Andy-Cheng1017/LEDCeliling/img/P4-indoor-full-color-LED-display-panel-256-256mm-64-64-dots-SMD2121-RGB.jpg

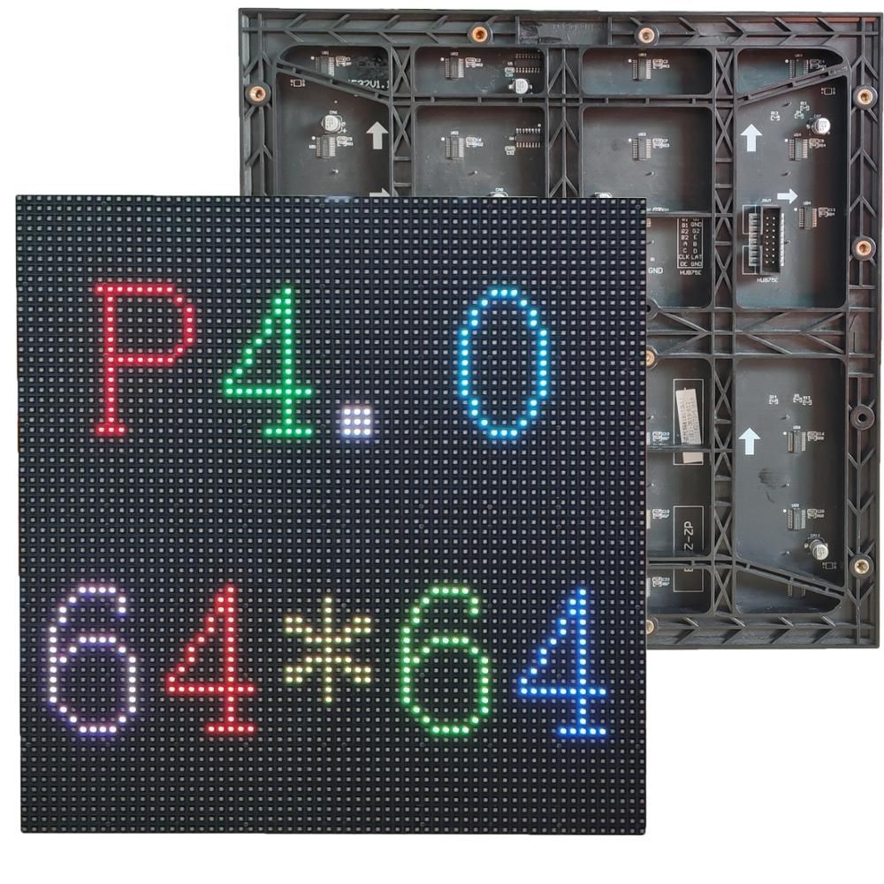
img/P4-indoor-full-color-LED-display-panel-256-256mm-64-64-dots-SMD2121-RGB.jpg
