Andy-Cheng1017/LEDCeliling/img/conbine v13.png

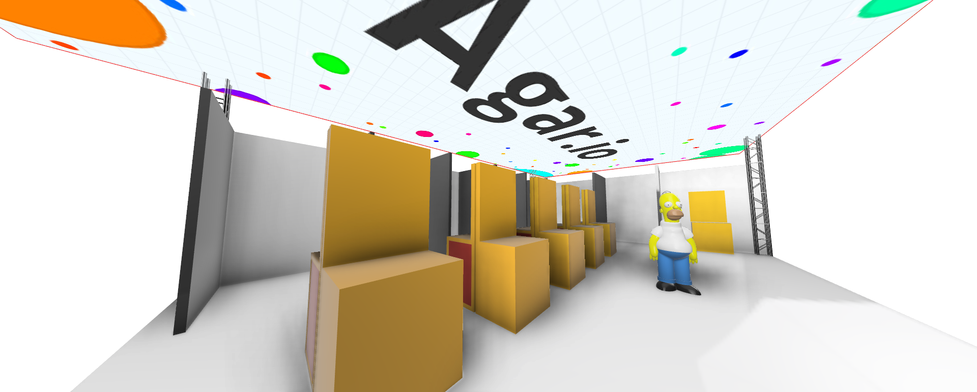
img/conbine v13.png
