Andy-Cheng1017/LEDCeliling/README.md

# LEDCeliling
 NTUT IXD Graduate Exhibition
