Andy-Cheng1017/LEDCeliling/1663770847968.jpg

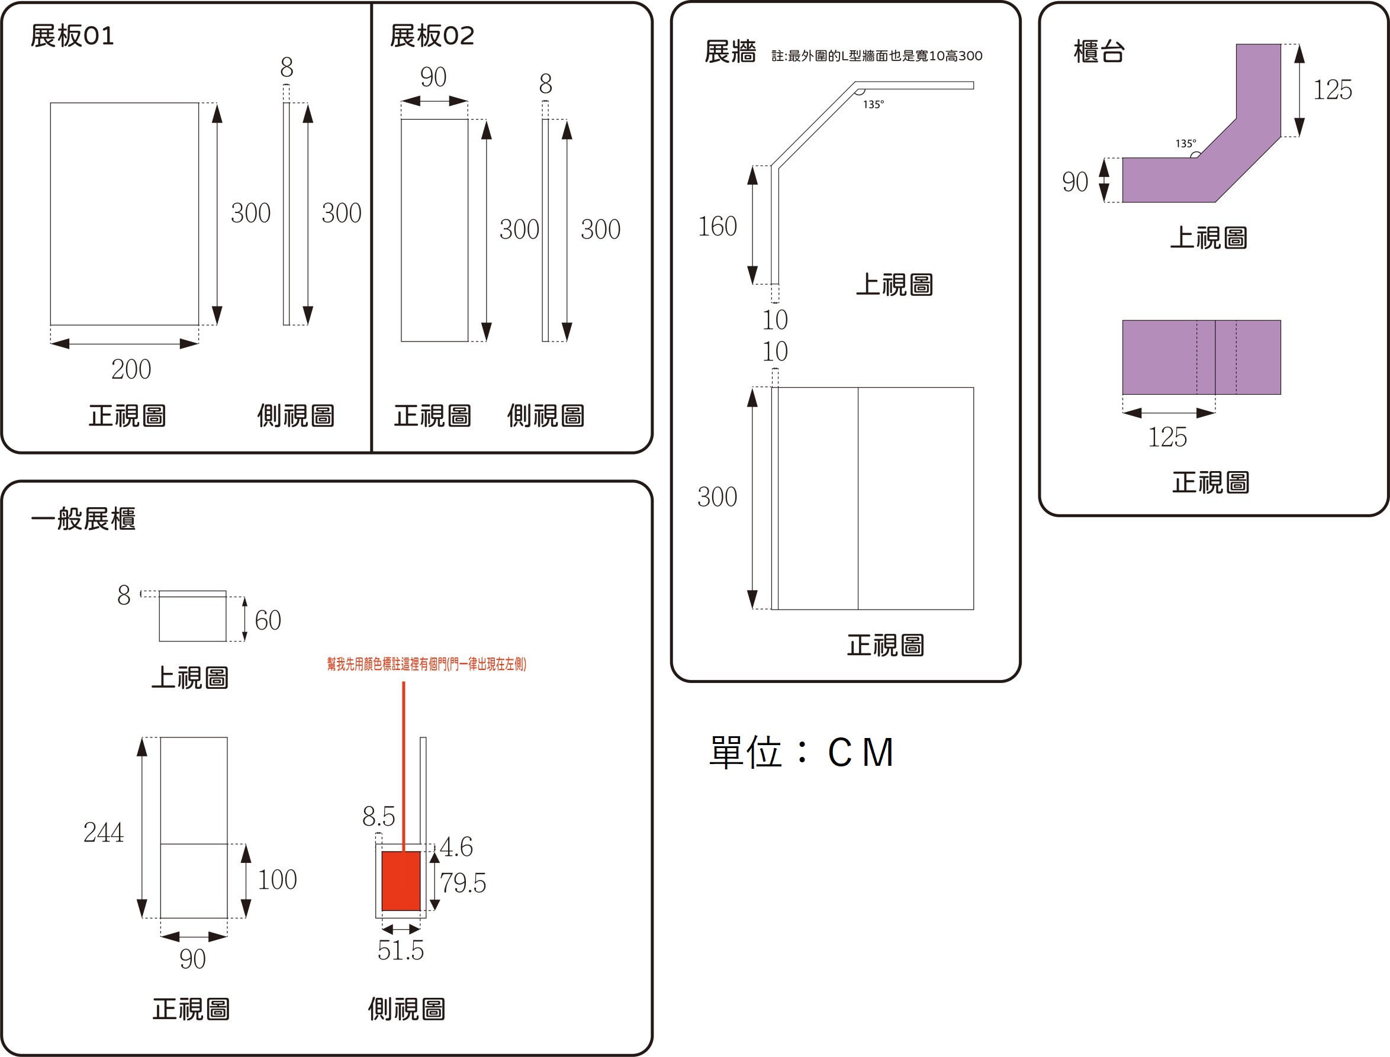
1663770847968.jpg
