Andy-Cheng1017/LEDCeliling/1663770881538.jpg

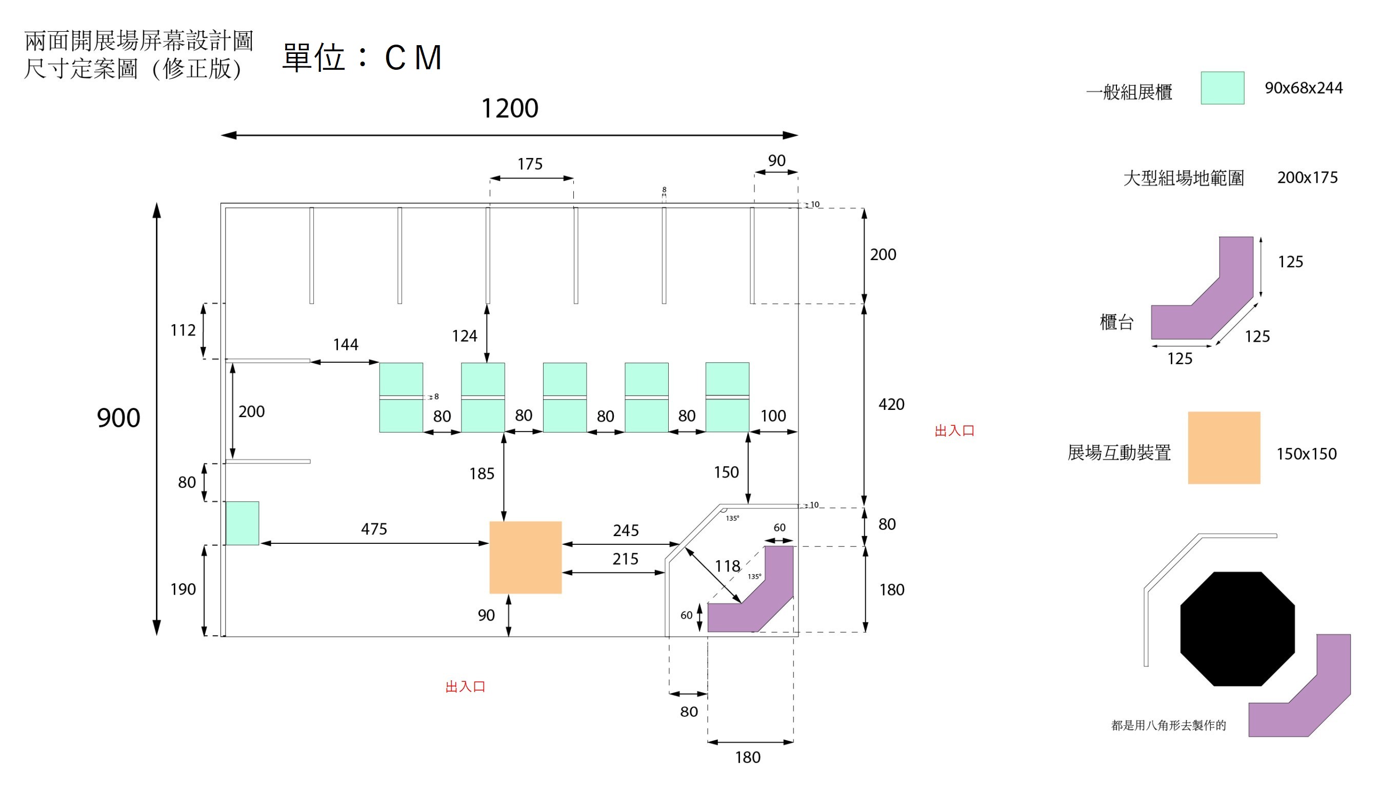
1663770881538.jpg
