Andy-Cheng1017/LEDCeliling/BoardCoverter/BoardCoverterPanelization.png

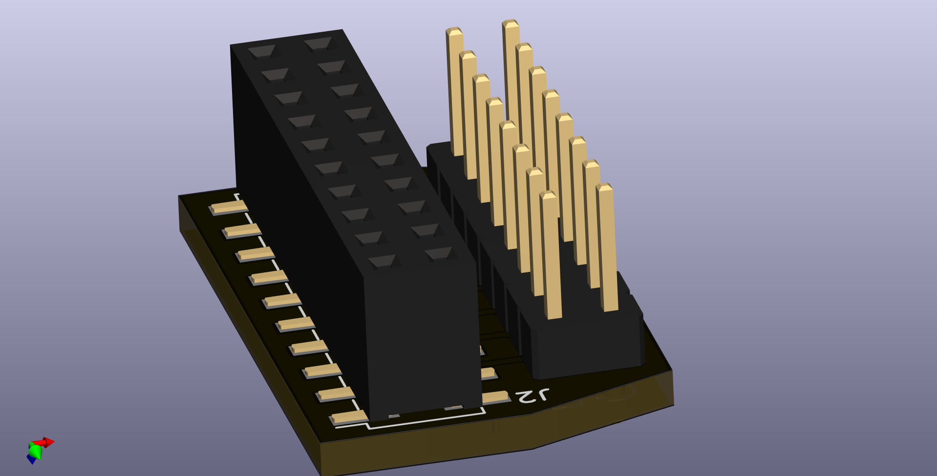
BoardCoverter/BoardCoverterPanelization.png
