Andy-Cheng1017/LEDCeliling/CameraPosition/2023-02-24 09.29.34.png

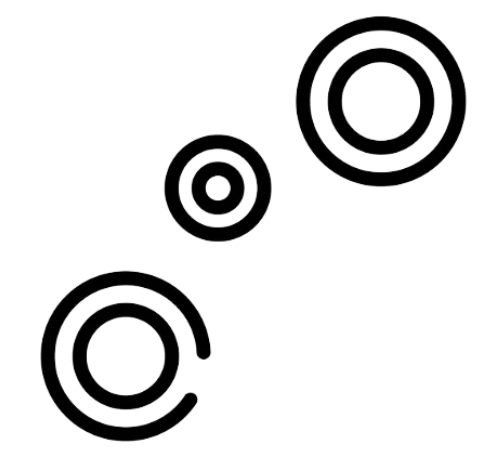
CameraPosition/2023-02-24 09.29.34.png
