Andy-Cheng1017/LEDCeliling/CameraPosition/CameraPosition2.png

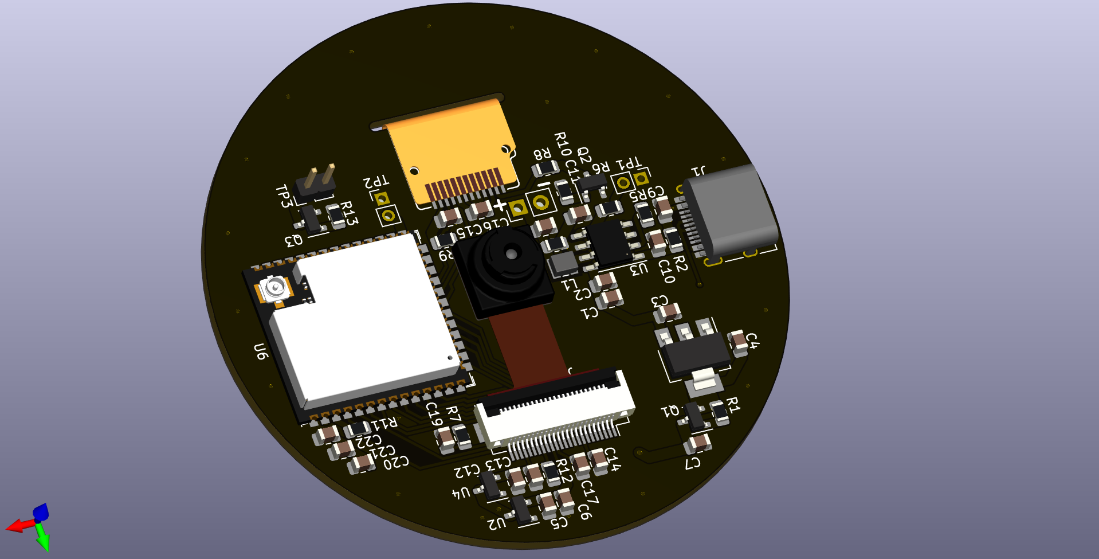
CameraPosition/CameraPosition2.png
