Andy-Cheng1017/LEDCeliling/CameraPosition/CameraPosition.png

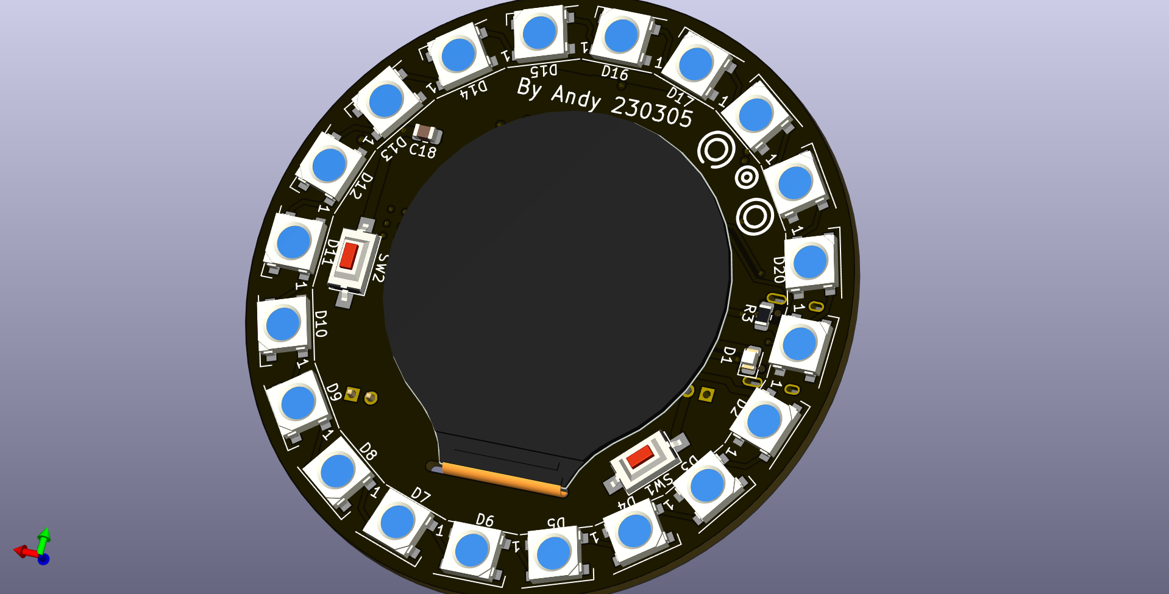
CameraPosition/CameraPosition.png
