Andy-Cheng1017/LEDCeliling/img/conbine 11.png

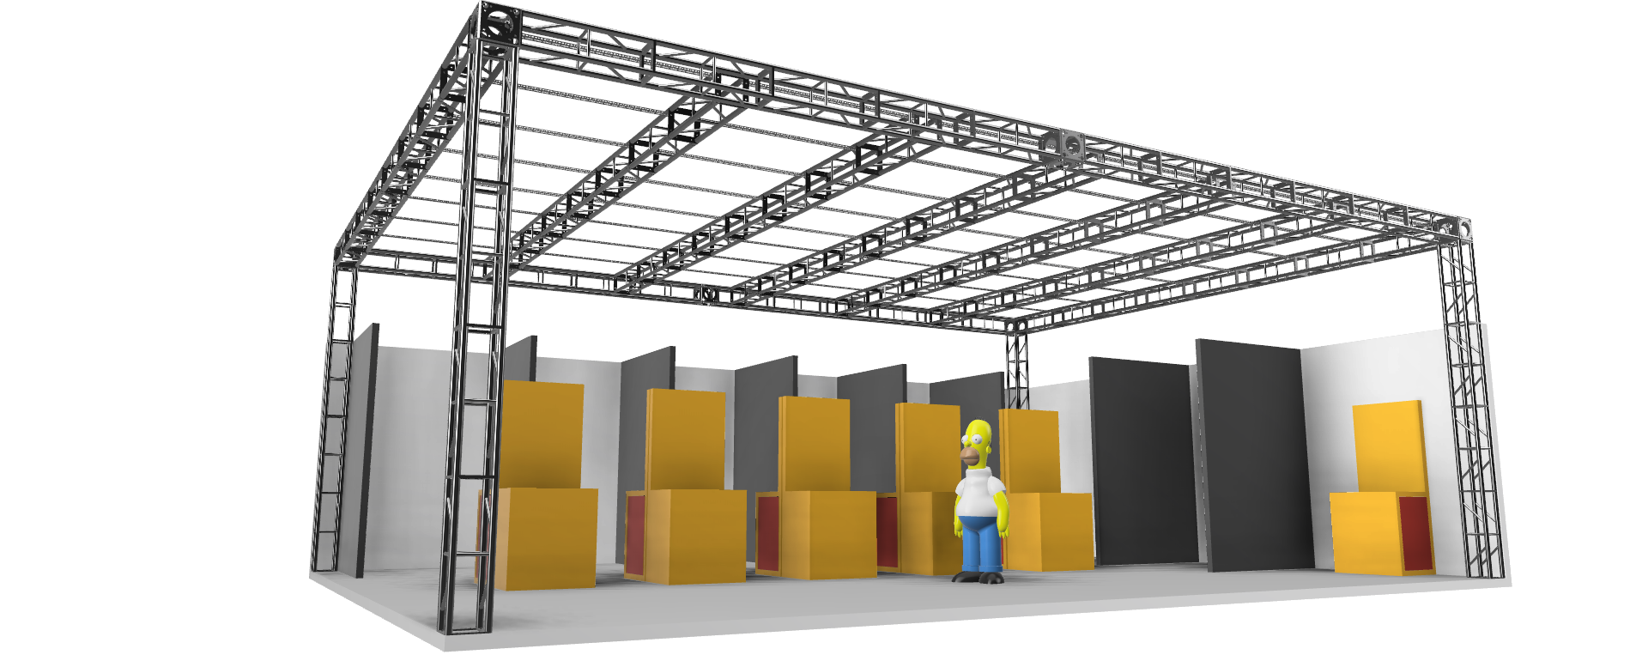
img/conbine 11.png
