Andy-Cheng1017/LEDCeliling/img/conbine v.png

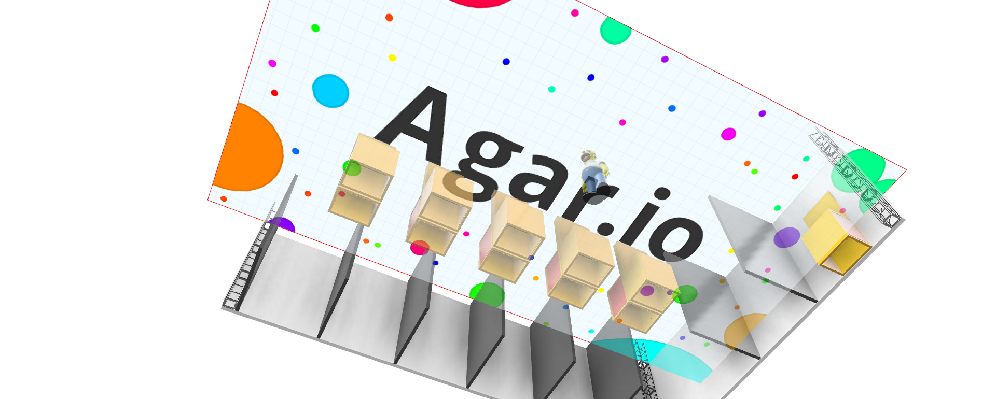
img/conbine v.png
