Andy-Cheng1017/LEDCeliling/img/Ibecon.drawio.png

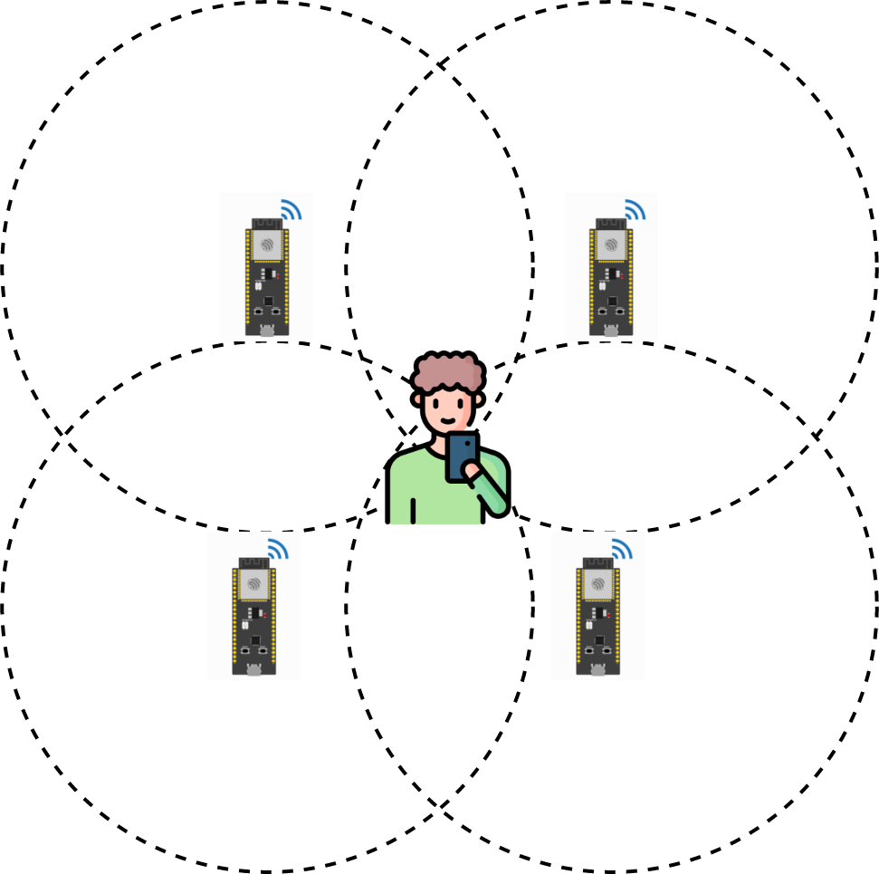
img/Ibecon.drawio.png
