Andy-Cheng1017/LEDCeliling/img/LED矩陣關係.drawio.png

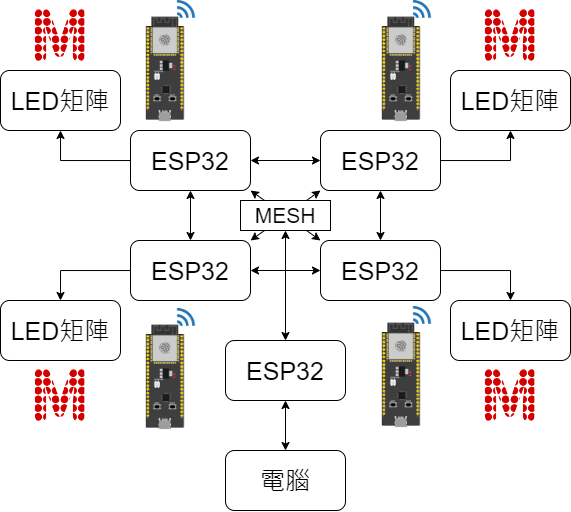
img/LED矩陣關係.drawio.png
