Andy-Cheng1017/LEDCeliling/img/Matrix.io (1).png

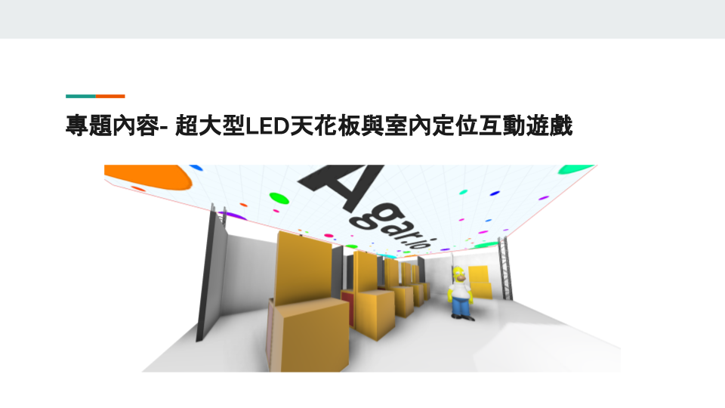
img/Matrix.io (1).png
