Andy-Cheng1017/LEDCeliling/img/Matrix.io (2).png

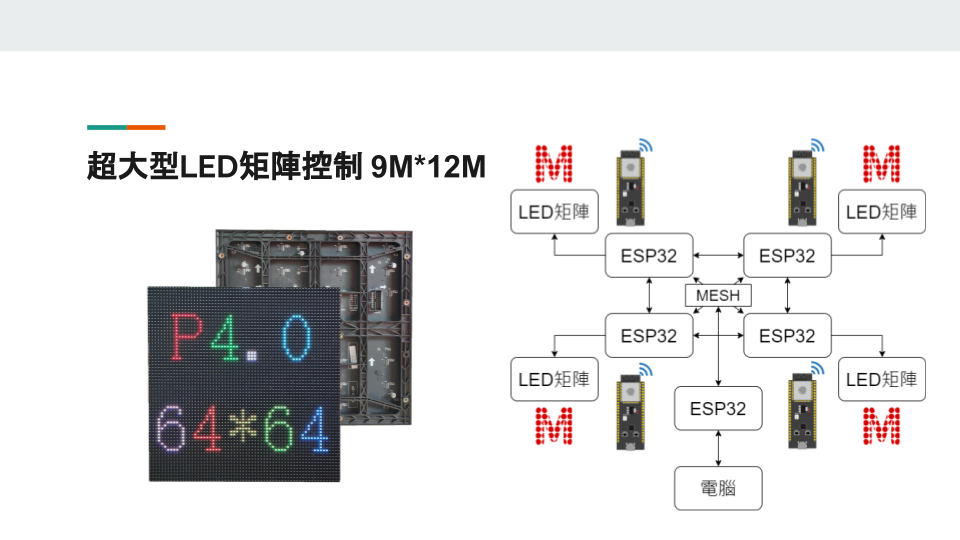
img/Matrix.io (2).png
