Andy-Cheng1017/LEDCeliling/img/Matrix.io (3).png

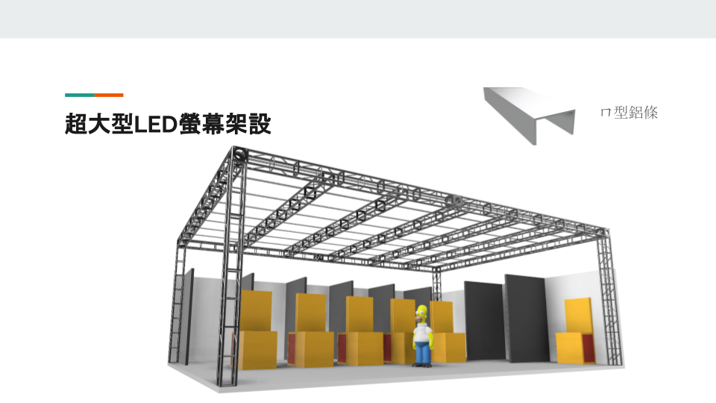
img/Matrix.io (3).png
