Andy-Cheng1017/LEDCeliling/img/Matrix.io (4).png

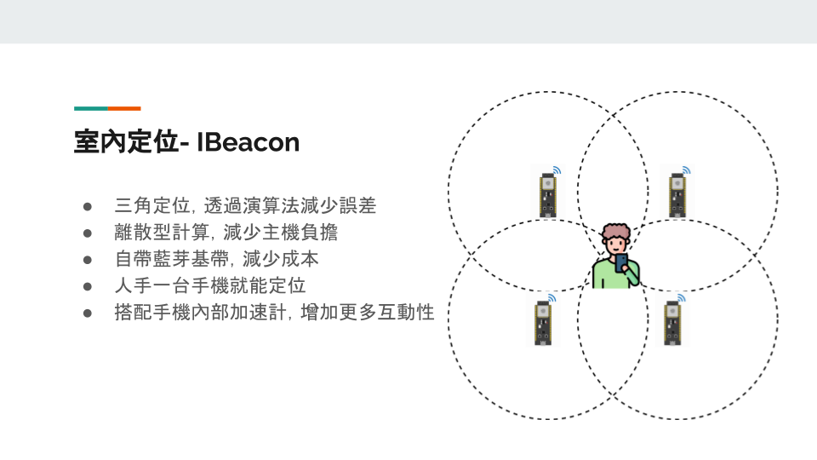
img/Matrix.io (4).png
