Andy-Cheng1017/LEDCeliling/img/Matrix.io (5).png

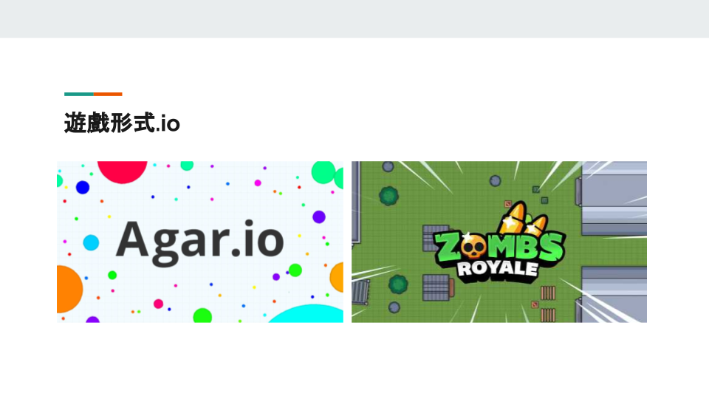
img/Matrix.io (5).png
