Andy-Cheng1017/LEDCeliling/img/Matrix.io (6).png

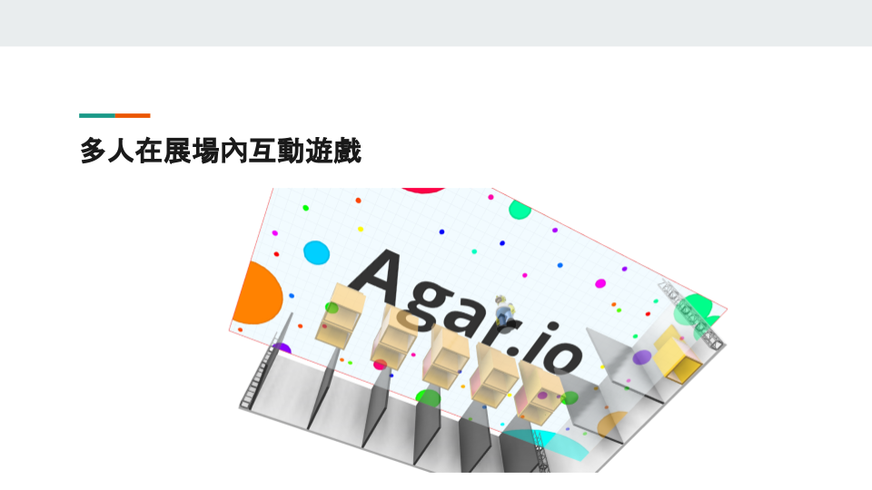
img/Matrix.io (6).png
