Andy-Cheng1017/LEDCeliling/Led_Control_Circuit/Led_Control_Circuit.png

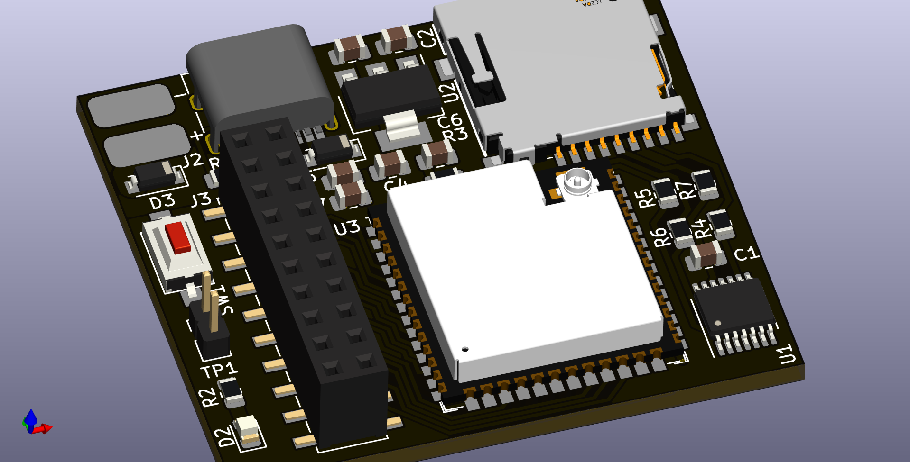
Led_Control_Circuit/Led_Control_Circuit.png
