Andy-Cheng1017/LEDCeliling/Power/Power2.png

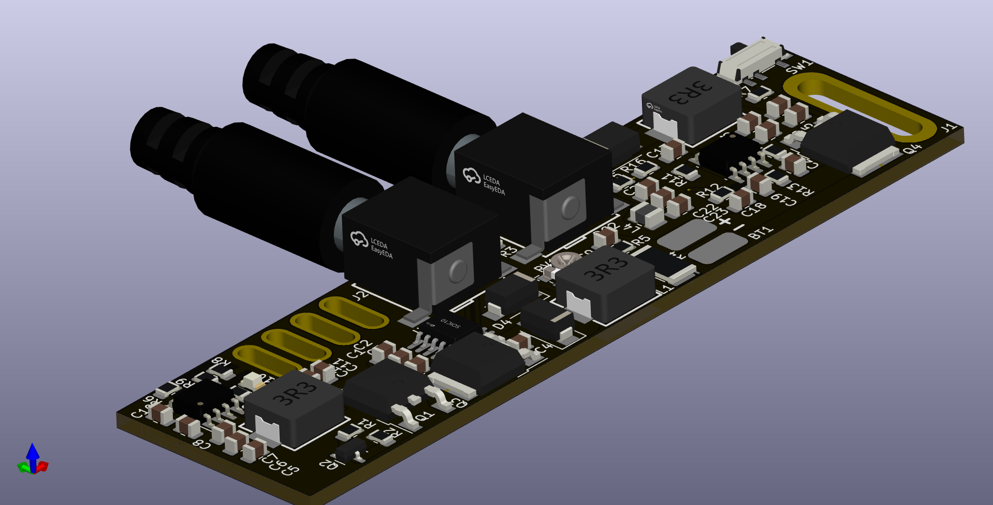
Power/Power2.png
