Andy-Cheng1017/LEDCeliling/Power/Power.png

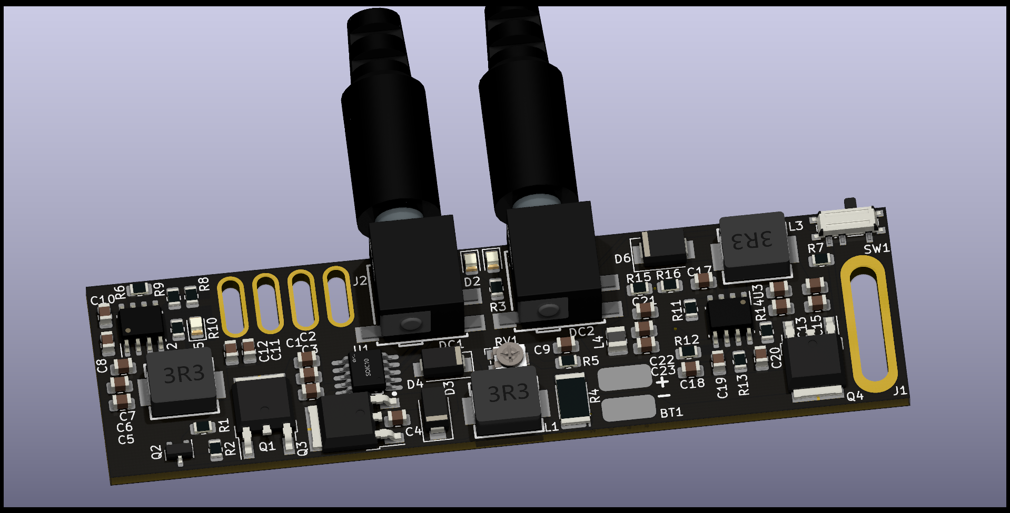
Power/Power.png
