Andy-Cheng1017/LEDCeliling/Component.xlsx

C2934267 (https://www.lcsc.com/product-detail/Chip-Resistor-Surface-Mount_FOJAN-FRL0805FR500TS_C2934267.html) | 10
C2849007 (https://www.lcsc.com/product-detail/Chip-Resistor-Surface-Mount_Resistor-Today-AECR0805F2R00S9_C2849007.html) | 10
C2907310 (https://www.lcsc.com/product-detail/Chip-Resistor-Surface-Mount_TyoHM-RMC0805225-N_C269553.html) | 10
C376921 (https://www.lcsc.com/product-detail/Chip-Resistor-Surface-Mount_TyoHM-RMC0805225-N_C269553.html) | 30
C344177 (https://www.lcsc.com/product-detail/Multilayer-Ceramic-Capacitors-MLCC-SMD-SMT_CCTC-TCC0805COG100J500BT_C344177.html) | 20
C376865 (https://www.lcsc.com/product-detail/Multilayer-Ceramic-Capacitors-MLCC-SMD-SMT_CCTC-TCC0805COG150J500BT_C376865.html) | 6
C3002651 (https://www.lcsc.com/product-detail/Power-Inductors_CENKER-CKST0605-15uH-M_C3002651.html) | 60
C2044935 (https://www.lcsc.com/product-detail/Inductors-SMD_Taiyo-Yuden-MEKK2520T1R0M_C2044935.html) | 10
C2995315 (https://www.lcsc.com/product-detail/Schottky-Barrier-Diodes-SBD_MSKSEMI-1N5819HW-MS_C2995315.html) | 30
C167447 (https://www.lcsc.com/product-detail/Inductors-SMD_Murata-Electronics-1239AS-H-1R0M-P2_C167447.html) | 20
C3002634 (https://www.lcsc.com/product-detail/Power-Inductors_CENKER-CKST0603-2-2uH-M_C3002634.html) | 20
C5356338 (https://www.lcsc.com/product-detail/Chip-Resistor-Surface-Mount_Sunway-SC0805J2003F4ANRH_C5356338.html) | 20
C5140879 (https://www.lcsc.com/product-detail/Chip-Resistor-Surface-Mount_Sunway-SC0805J2202F4ANRH_C5140879.html) | 20
C5140646 (https://www.lcsc.com/product-detail/Chip-Resistor-Surface-Mount_Sunway-SC0805J3301F4ANRH_C5140646.html) | 100
C2907330 (https://www.lcsc.com/product-detail/Chip-Resistor-Surface-Mount_FOJAN-FRC0805J473-TS_C2907330.html) | 100
C2930296 (https://www.lcsc.com/product-detail/Chip-Resistor-Surface-Mount_Sunway-SC0805J5101F4ANRH_C5140644.html) | 20
C913246 (https://www.lcsc.com/product-detail/Variable-Resistors-Potentiometers_BOURNS-TC33X-2-503E_C913246.html) | 20
C5356361 (https://www.lcsc.com/product-detail/Chip-Resistor-Surface-Mount_Sunway-SC0805J5102F4ANRH_C5356361.html) | 20
C7813 (https://www.lcsc.com/product-detail/Buffer-Driver-Transceiver_Texas-Instruments-SN74LVC125APWR_C7813.html) | 20
C5181460 (https://www.lcsc.com/product-detail/Linear-Voltage-Regulators-LDO_HX-hengjiaxing-AMS1117-3-3_C5181460.html) | 30
C5342366 (https://www.lcsc.com/product-detail/MOSFETs_TECH-PUBLIC-AOD417_C5342366.html) | 50
C2856805 (https://www.lcsc.com/product-detail/FFC-FPC-Connectors_XUNPU-FPC-05F-24PH20_C2856805.html) | 10
C3018536 (https://www.lcsc.com/product-detail/Schottky-Barrier-Diodes-SBD_FUXINSEMI-SS54_C3018536.html) | 50
C2903947 (https://www.lcsc.com/product-detail/Schottky-Barrier-Diodes-SBD_GOODWORK-SS1045-SMB_C2903947.html) | 20
C114311 (https://www.lcsc.com/product-detail/DC-DC-Converters_Advanced-Analog-Technology-FP6188XR-G1_C114311.html) | 45
C133888 (https://www.lcsc.com/product-detail/DC-DC-Converters_Advanced-Analog-Technology-FP6296XR-G1_C133888.html) | 20
C845610 (https://www.lcsc.com/product-detail/MOSFETs_HUASHUO-HSU60P02_C845610.html) | 50
C181692 (https://www.lcsc.com/product-detail/Battery-Management-ICs_INJOINIC-IP5306_C181692.html) | 20
C5261052 (https://www.lcsc.com/product-detail/MOSFETs_HXY-MOSFET-SI2301-ZE_C5261052.html) | 20
C2888455 (https://www.lcsc.com/product-detail/Tactile-Switches_BZCN-TSB008A2518A_C2888455.html) | 50
C91145 | 20
C5252897 (https://www.lcsc.com/product-detail/Linear-Voltage-Regulators-LDO_MSKSEMI-XC6206P282MR-MS_C5252897.html) | 20
C2827649 (https://www.lcsc.com/product-detail/Linear-Voltage-Regulators-LDO_TECH-PUBLIC-XC6206P122MR-1uA_C2827649.html) | 20
