Andy-Cheng1017/LEDCeliling/Power/PowerBOM.xlsx

Comment | Designator | Footprint | JLCPCB Part
10u | C1, C2, C5, C6, C9, | Capacitor_SMD:C_0805_2012Metric | C15850
1u | C3, C17, C20, | Capacitor_SMD:C_0805_2012Metric | C2798196
0.1u | C4, C7, C10, | Capacitor_SMD:C_0805_2012Metric | C282732
10n | C8, | Capacitor_SMD:C_0805_2012Metric | C376921
22u | C11, C12, C13, C14, C15, C16, C21, C22, C23, | Capacitor_SMD:C_0805_2012Metric | C45783
10p | C18, C19, | Capacitor_SMD:C_0805_2012Metric | C344177
LED | D1, D5, | LED_SMD:LED_0805_2012Metric | C965812
LED | D2 | LED_SMD:LED_0805_2012Metric | C965816
D_Schottky | D3, D4, | Diode_SMD:D_SMA | C3018536
D_Schottky | D6, | Diode_SMD:D_SMB | C2903947
KH-DC-044D-2.0STM | DC1, DC2, | 1component:DC-044D-2.5A-2.5-SMT | C397343
15u | L1, L2, | 1component:IND-SMD_L7.5-W6.6 | C3002651
2.2u | L3, | 1component:IND-SMD_L7.5-W6.6 | C3002634
1u | L4, | Inductor_SMD:L_1008_2520Metric | C2044935
AOD417 | Q1, Q3, | Package_TO_SOT_SMD:TO-252-2 | C4748754
2N7002 | Q2, | Package_TO_SOT_SMD:SOT-23 | C3008370
HSU60P02 | Q4, | Package_TO_SOT_SMD:TO-252-2 | C845610
10K | R1, R2, R7, R9, | Resistor_SMD:R_0805_2012Metric | C3152217
1K | R3, R10, | Resistor_SMD:R_0805_2012Metric | C17414
100k | R5, R6, R11, R12, | Resistor_SMD:R_0805_2012Metric | C149504
46.5K | R8, | Resistor_SMD:R_0805_2012Metric | C17704
51k | R13, | Resistor_SMD:R_0805_2012Metric | C5356361
100 | R14, | Resistor_SMD:R_0805_2012Metric | C25277
200k | R15, | Resistor_SMD:R_0805_2012Metric | C5356338
22K | R16, | Resistor_SMD:R_0805_2012Metric | C5140879
50K | RV1, | 1component:Potentiometer_Bourns_TC33X_Vertical | C145161
SW_SPDT | SW1, | Button_Switch_SMD:SW_SPDT_PCM12 | C431540
CN3765 | U1, | 1component:SOIC-10_L4.9-W3.9-P1.00-LS6.0-BL | C41308
FP6188XR-G1 | U2, | 1component:SOIC-8-1EP_3.9x4.9mm_P1.27mm_EP2.95x4.9mm_Mask2.71x3.4mm_ThermalVias | C114311
FP6296XR-G1 | U3, | 1component:SOIC-8-1EP_3.9x4.9mm_P1.27mm_EP2.95x4.9mm_Mask2.71x3.4mm_ThermalVias | C133888
