Andy-Cheng1017/LEDCeliling/esp32 S3文件/ESP32-S3-WROOM-1U_V1.4_Reference_Design/ESP32-S3-WROOM-1U_V1.4_Reference_Design/05_Bom/BOM(V0.7)_ESP32-S3-WROOM-1U.xls

BOM(V0.7)_ESP32-S3-WROOM-1U
Item | Quantity | Reference | Value | Package | ICs | Description | Notes
1 | 1 | ANT1 | USS RF Receptacle Connector, Generation I, 60 VAC, DC ~ 6 G, 50 ± 5 Ω | IPEX_3P | Connector | RF Connector
2 | 2 | C1, C4 | TBD | C0201 | Capacitor | Ceramic Capacitors | Defined by RF Test
3 | 1 | C2 | 10 nF / 10 V (10%) | C0201 | Capacitor | Ceramic Capacitors
4 | 3 | C3, C7, C14 | 1 uF / 6.3 V (20%) | C0201 | Capacitor | Ceramic Capacitors
5 | 1 | C6 | 10 uF / 6.3 V (20%) | C0402 | Capacitor | Ceramic Capacitors
6 | 5 | C8, C9, C10, C13, C15 | 0.1 uF / 10 V (10%) | C0201 | Capacitor | Ceramic Capacitors
7 | 1 | C11 | TBD | C0201 | Capacitor | Ceramic Capacitors | Defined by RF Test
8 | 1 | C12 | TBD | C0201 | Capacitor | Ceramic Capacitors | Defined by RF Test
9 | 1 | L2 | TBD | L0201 | Inductor | Inductor | Defined by RF Test
10 | 1 | L1 | 2.0 nH (0.1 nH), 600 mA | L0201 | Resistor | Chip Resistors | Defined by RF Test
11 | 1 | R3 | 499 Ω (1%), 1/20 W | R0201 | Resistor | Chip Resistors
12 | 1 | R4 | 24 nH (3%), 140 mA | R0201 | Inductor | Inductor | Defined by RF Test
13 | 5 | R10, R13, R14, R15, R16 | 0 Ω (1%), 1/20 W | R0201 | Resistor | Chip Resistors
14 | 1 | D1 | TVS Diode, Bi-Direction, 3.3V | SOD882 | ESD / TVS | TVS Diode, 3.3 V
15 | 1 | U1 | ESP32-S3, Wi-Fi + BT + MCU + PSRAM (opt.) | QFN56_0P4_7 | Chip | Wi-Fi + BT + MCU + PSRAM (opt.)
16 | 1 | U2 | 2.3 ~ 3.6 V, Standard & Dual & Quad SPI flash | SOP8_1P27_6P6 | Chip | 3.3 V SPI FLASH
17 | 1 | Y1 | 40 MHz, ±7 ppm, 15 pF, 100 uW | XTAL3225 | Cystal | 40 MHz Crystal
18 | 1 | Shield Box | Shield Box Size: 15.65 mm * 17.5 mm * 2.4 mm, T = 0.20 mm, Material: C7701R-H | - | - | -
19 | 1 | PCB | ESP32-S3-WROOM-1U V1.4, 4L, 18 mm * 19.2 mm * 0.8 mm, Halogen-free, Matte black for Solder mask and white for silkscreen, immersion gold and 50 Ω impedance control. | - | - | -
*Please be noted that C11, C12 and L2 are recommended to use Murata for good quality and accuracy.
