Andy-Cheng1017/LEDCeliling/整理.xlsx

Ref | Qnty | Total | Value | Footprint | LCSC
R4, | 1 | 6 | 0.5 | Resistor_SMD:R_0805_2012Metric
R2, | 1 | 6 | 2 | Resistor_SMD:R_0805_2012Metric
R8, | 1 | 6 | 22 | Resistor_SMD:R_0805_2012Metric
R14, | 1 | 10 | 100 | Resistor_SMD:R_0805_2012Metric
C1, C7, | 2 | 20 | 0.1u | Capacitor_SMD:C_0805_2012Metric
C5, C12, C15, C16, C17, C19, C22, | 7 | 42 | 0.1u | Capacitor_SMD:C_0805_2012Metric
C4, C7, C10, | 3 | 30 | 0.1u | Capacitor_SMD:C_0805_2012Metric
C7, C10, | 2 | 40 | 0.1u | Capacitor_SMD:C_0805_2012Metric
R5, | 1 | 10 | 100K | Resistor_SMD:R_0805_2012Metric
R6, R11, R12, | 3 | 30 | 100k | Resistor_SMD:R_0805_2012Metric
R6, | 1 | 20 | 100k | Resistor_SMD:R_0805_2012Metric
R1, R6, R7, R10, R13, | 5 | 30 | 10k | Resistor_SMD:R_0805_2012Metric
R9, | 1 | 6 | 10K | Resistor_SMD:R_0805_2012Metric
R1, R2, R7, R9, | 4 | 40 | 10K | Resistor_SMD:R_0805_2012Metric
R9, | 1 | 20 | 10K | Resistor_SMD:R_0805_2012Metric
C8, | 1 | 10 | 10n | Capacitor_SMD:C_0805_2012Metric
C8, | 1 | 20 | 10n | Capacitor_SMD:C_0805_2012Metric
C18, C19, | 2 | 20 | 10p | Capacitor_SMD:C_0805_2012Metric
C4, | 1 | 10 | 10u | Capacitor_SMD:C_0805_2012Metric
C1, C2, C6, C7, C9, C10, C13, C20, | 8 | 48 | 10u | Capacitor_SMD:C_0805_2012Metric
C1, C2, C5, C6, C9, | 5 | 50 | 10u | Capacitor_SMD:C_0805_2012Metric
C5, C6, | 2 | 40 | 10u | Capacitor_SMD:C_0805_2012Metric
C14, | 1 | 6 | 15p | Capacitor_SMD:C_0805_2012Metric
L1, L2, | 2 | 20 | 15u | 1component:IND-SMD_L7.5-W6.6
L2, | 1 | 20 | 15u | 1component:IND-SMD_L7.5-W6.6
R2, | 1 | 10 | 1k | Resistor_SMD:R_0805_2012Metric
R3, | 1 | 10 | 1K | Resistor_SMD:R_0805_2012Metric
R5, R11, R12, | 3 | 18 | 1K | Resistor_SMD:R_0805_2012Metric
R3, R10, | 2 | 20 | 1K | Resistor_SMD:R_0805_2012Metric
R10, | 1 | 20 | 1K | Resistor_SMD:R_0805_2012Metric
L1, | 1 | 6 | 1u | Inductor_SMD:L_Wuerth_MAPI-2512
D1, D3, | 2 | 20 | 1N5819HW | Diode_SMD:D_SOD-123
C2, C3, C5, C6, | 4 | 40 | 1u | Capacitor_SMD:C_0805_2012Metric
C3, C4, C18, C21, | 4 | 24 | 1u | Capacitor_SMD:C_0805_2012Metric
C3, C17, C20, | 3 | 30 | 1u | Capacitor_SMD:C_0805_2012Metric
L4, | 1 | 10 | 1u | Inductor_SMD:L_1008_2520Metric
L3, | 1 | 10 | 2.2u | 1component:IND-SMD_L7.5-W6.6
R15, | 1 | 10 | 200k | Resistor_SMD:R_0805_2012Metric
R16, | 1 | 10 | 22K | Resistor_SMD:R_0805_2012Metric
C8, C11, | 2 | 12 | 22u | Capacitor_SMD:C_0805_2012Metric
C11, C12, C13, C14, C15, C16, C21, C22, C23, | 9 | 90 | 22u | Capacitor_SMD:C_0805_2012Metric
C11, C12, | 2 | 40 | 22u | Capacitor_SMD:C_0805_2012Metric
Q2, Q3, | 2 | 12 | 2N7002 | Package_TO_SOT_SMD:SOT-23
Q2, | 1 | 10 | 2N7002 | Package_TO_SOT_SMD:SOT-23
R4, R5, R6, R7, | 4 | 40 | 3.3K | Resistor_SMD:R_0805_2012Metric
R8, | 1 | 10 | 46.5K | Resistor_SMD:R_0805_2012Metric
R8, | 1 | 20 | 46.5K | Resistor_SMD:R_0805_2012Metric
R1, | 1 | 10 | 5.1K | Resistor_SMD:R_0805_2012Metric
R3, | 1 | 6 | 5.1K | Resistor_SMD:R_0805_2012Metric
RV1, | 1 | 10 | 50K | 1component:Potentiometer_Bourns_TC33X_Vertical
R13, | 1 | 10 | 51k | Resistor_SMD:R_0805_2012Metric
U1, | 1 | 10 | 74LVC125 | Package_SO:TSSOP-14_4.4x5mm_P0.65mm
U1, | 1 | 6 | AMS1117 | Package_TO_SOT_SMD:SOT-223-3_TabPin2
U2, | 1 | 10 | AMS1117-3.3 | Package_TO_SOT_SMD:SOT-223-3_TabPin2
Q1, Q3, | 2 | 20 | AOD417 | Package_TO_SOT_SMD:TO-252-2
U1, | 1 | 10 | CN3765 | 1component:SOIC-10_L4.9-W3.9-P1.00-LS6.0-BL
J1, | 1 | 20 | Conn_01x01 | 1component:GndConnect
J2, | 1 | 20 | Conn_01x04 | 1component:VH3.96 4P SMT
J3, | 1 | 10 | Conn_01x20 | Connector_PinSocket_2.54mm:PinSocket_2x10_P2.54mm_Vertical_SMD
J2, | 1 | 6 | Conn_01x25 | 1Use:Hirose_FH12-24S-0.5SH_1x24-1MP_P0.50mm_Horizontal
D3, D4, | 2 | 20 | D_Schottky | Diode_SMD:D_SMA
D6, | 1 | 10 | D_Schottky | Diode_SMD:D_SMB
U3, | 1 | 10 | ESP32-S3-WROOM-1 | Espressif:ESP32-S3-WROOM-1U
U6, | 1 | 6 | ESP32-S3-WROOM-1 | Espressif:ESP32-S3-WROOM-1U
U2, | 1 | 10 | FP6188XR-G1 | 1component:SOIC-8-1EP_3.9x4.9mm_P1.27mm_EP2.95x4.9mm_Mask2.71x3.4mm_ThermalVias
U2, | 1 | 20 | FP6188XR-G1 | 1component:SOIC-8-1EP_3.9x4.9mm_P1.27mm_EP2.95x4.9mm_Mask2.71x3.4mm_ThermalVias
U3, | 1 | 10 | FP6296XR-G1 | 1component:SOIC-8-1EP_3.9x4.9mm_P1.27mm_EP2.95x4.9mm_Mask2.71x3.4mm_ThermalVias
U5, | 1 | 6 | GC9A01_IPS_display_SPI | 1Use:GC9A01_IPS_display
Q4, | 1 | 10 | HSU60P02 | Package_TO_SOT_SMD:TO-252-2
U3, | 1 | 6 | IP5306 | Package_SO:SOIC-8-1EP_3.9x4.9mm_P1.27mm_EP2.29x3mm
DC1, DC2, | 2 | 20 | KH-DC-044D-2.0STM | 1component:DC-IN-TH_KH-DC-044D-2.0STM
DC1, DC2, | 2 | 40 | KH-DC-044D-2.0STM | 1component:DC-IN-TH_KH-DC-044D-2.0STM
D1, | 1 | 6 | LED | LED_SMD:LED_0805_2012Metric
D1, D2, D5, | 3 | 30 | LED | LED_SMD:LED_0805_2012Metric
D5, | 1 | 20 | LED | LED_SMD:LED_0805_2012Metric
D2, | 1 | 10 | LED0805 | LED_SMD:LED_0805_2012Metric
Q1, | 1 | 6 | Q_PMOS_GSD | Package_TO_SOT_SMD:SOT-23
R4, | 1 | 10 | R_Shunt | 1component:R_2512_6332Metric
SW1, | 1 | 10 | SW_Push | Button_Switch_SMD:SW_SPST_CK_RS282G05A3
SW1, SW2, | 2 | 12 | SW_Push | Button_Switch_SMD:SW_SPST_CK_RS282G05A3
SW1, | 1 | 10 | SW_SPDT | Button_Switch_SMD:SW_SPDT_PCM12
Card1, | 1 | 10 | TF-01A | SDCard:TF-SMD_TF-01A
J1, | 1 | 10 | USB_C_Receptacle_USB2.0 | 1Comment:USB_C_Receptacle_HRO_TYPE-C-31-M-12
J1, | 1 | 6 | USB_C_Receptacle_USB2.0 | 1Use:USB_C_Receptacle_HRO_TYPE-C-31-M-12
D2, D3, D4, D5, D6, D7, D8, D9, D10, D11, D12, D13, D14, D15, D16, D17, D18, D19, D20, D21, | 20 | 120 | WS2812B | LED_SMD:LED_WS2812B_PLCC4_5.0x5.0mm_P3.2mm
U2, | 1 | 6 | XC6206P122MR | Package_TO_SOT_SMD:SOT-23
U4, | 1 | 6 | XC6206P282MR | Package_TO_SOT_SMD:SOT-23
