Andy-Cheng1017/LEDCeliling/價格計算.xlsx

Sheet: LED間隔2cm
場地 | 長 | 寬 | 角鋼 | 立柱 | 天花板邊長 |  |  | esp32 掃描半徑 | WS2812最大數量 |  | 角鋼長度 | 角鋼數量 | 角鋼總長度
 | 1200 | 900 | 30 | 6 | 60 |  |  | 60 | 450 |  | 1100 | 14 | 15400
有效長寬 | X | Y |  |  | X軸數量 | Y軸數量 | 天花板數量 | esp32 X軸數量 | esp32 Y軸數量 | esp32數量
 | 1100 | 800 |  |  | 18 | 13 | 234 | 9 | 7 | 63
 |  |  |  |  | 天花板面積 | 額外預備片數比例 | 額外預備片數 | 每片乘載LED | 每片需要pin | esp32總數量
 |  |  |  |  | 842400 | 0.05 | 12 | 3350 | 8 | 67
 |  |  |  |  |  |  | 天花板總數量
品名 | 單價 | 數量 | 額外費用 | 總價 |  |  | 246
WS2812B5050 | 0.3 | 221130 |  | 66339
密迪板(4尺*8尺)*10片 | 300 | 4 |  | 1200
pcb板 | 30000 | 1 |  | 30000
電容 | 0.00352 | 221130 |  | 778.3776
電路加工費 | 1600 | 1 |  | 1600 | LED間隔 |  |  | PCB板大小 | 拼板大小
esp32、天線 | 180 | 67 |  | 12060 | 2 |  |  | 1 | 10
ESP32-S3-WROOM-1U N8R8 |  |  | 全部價格 | 111977.3776 | X軸數量 | Y軸數量 | LED數量 | 拼板上數量 | 總需要數量
 |  |  |  |  | 540 | 390 | 210600 | 100 | 2220
 |  |  |  |  | LED總數量
 |  |  |  |  | 221130
 |  |  |  |  | 單位X軸LED數量 | 單位Y軸LED數量 | 單位LED總數量
 |  |  |  |  | 30 | 30 | 900

Sheet: LED間隔3cm
場地 | 長 | 寬 | 角鋼 | 立柱 | 天花板邊長 |  |  | esp32 掃描半徑 | WS2812最大數量 |  | 角鋼長度 | 角鋼數量 | 角鋼總長度
 | 1200 | 900 | 30 | 6 | 60 |  |  | 60 | 200 |  | 1100 | 14 | 15400
有效長寬 | X | Y |  |  | X軸數量 | Y軸數量 | 天花板數量 | esp32 X軸數量 | esp32 Y軸數量 | esp32數量
 | 1100 | 800 |  |  | 18 | 13 | 234 | 9 | 7 | 63
 |  |  |  |  | 天花板面積 | 額外預備片數比例 | 額外預備片數 | 每片乘載LED | 每片需要pin | esp32總數量
 |  |  |  |  | 842400 | 0.05 | 12 | 1490 | 8 | 67
 |  |  |  |  |  |  | 天花板總數量
品名 | 單價 | 數量 | 額外費用 | 總價 |  |  | 246
WS2812B5050 | 0.446 | 98280 |  | 43833
密迪板(4尺*8尺)*10片 | 300 | 4 |  | 1200
pcb板 | 12300 | 1 |  | 12300
電容 | 0.00352 | 98280 |  | 345.9456
電路加工費 | 1200 | 1 |  | 1200 | LED間隔 |  |  | PCB板大小 | 拼板大小
esp32、天線 | 180 | 67 |  | 12060 | 3 |  |  | 1 | 10
ESP32-S3-WROOM-1U N8R8 |  |  | 全部價格 | 70938.9456 | X軸數量 | Y軸數量 | LED數量 | 拼板上數量 | 總需要數量
 |  |  |  |  | 360 | 260 | 93600 | 100 | 990
 |  |  |  |  | LED總數量
 |  |  |  |  | 98280
 |  |  |  |  | 單位X軸LED數量 | 單位Y軸LED數量 | 單位LED總數量
 |  |  |  |  | 20 | 20 | 400

Sheet: LED間隔5cm
場地 | 長 | 寬 | 角鋼 | 立柱 | 天花板邊長 |  |  | esp32 掃描半徑 | WS2812最大數量 |  | 角鋼長度 | 角鋼數量 | 角鋼總長度
 | 1200 | 900 | 30 | 6 | 60 |  |  | 60 | 72 |  | 1100 | 14 | 15400
有效長寬 | X | Y |  |  | X軸數量 | Y軸數量 | 天花板數量 | esp32 X軸數量 | esp32 Y軸數量 | esp32數量
 | 1100 | 800 |  |  | 18 | 13 | 234 | 9 | 7 | 63
 |  |  |  |  | 天花板面積 | 額外預備片數比例 | 額外預備片數 | 每片乘載LED | 每片需要pin | esp32總數量
 |  |  |  |  | 842400 | 0.05 | 12 | 540 | 8 | 67
 |  |  |  |  |  |  | 天花板總數量
品名 | 單價 | 數量 | 額外費用 | 總價 |  |  | 246
WS2812B5050 | 0.67 | 35390 |  | 23711
密迪板(4尺*8尺)*10片 | 300 | 4 |  | 1200
pcb板 | 5200 | 1 |  | 5200
電容 | 0.00352 | 35390 |  | 124.5728
電路加工費 | 1100 | 1 |  | 1100 | LED間隔 |  |  | PCB板大小 | 拼板大小
esp32、天線 | 180 | 67 |  | 12060 | 5 |  |  | 1 | 10
ESP32-S3-WROOM-1U N8R8 |  |  | 全部價格 | 43395.5728 | X軸數量 | Y軸數量 | LED數量 | 拼板上數量 | 總需要數量
 |  |  |  |  | 216 | 156 | 33696 | 100 | 360
 |  |  |  |  | LED總數量
 |  |  |  |  | 35390
 |  |  |  |  | 單位X軸LED數量 | 單位Y軸LED數量 | 單位LED總數量
 |  |  |  |  | 12 | 12 | 144

Sheet: P4
場地 | 長 | 寬 |  | 單片LED | 長 | 寬 | 單價 | 模組 | 長 | 寬 | 數量 | 單價 | 單片esp32控制數量 | esp32總量 | 占地長寬 |  | HUB75腳位數量
 | 1200 | 900 |  |  | 32 | 16 | 30 | 數量 | 2 | 4 | 8 | 240 | 4 | 63 | 長 | 128
 |  |  |  |  |  |  |  | 長度 | 64 | 64 |  |  |  |  | 寬 | 128
場地模組數量 | 長 | 寬 | 總數 | 總價
 | 18 | 14 | 252 | 60480 |  |  |  | 0.00365
 |  |  | 2016 |  |  |  |  | 33.6384
 |  |  |  |  |  |  |  | 61.875
 |  |  |  |  |  |  |  | 203
 |  |  |  |  |  |  |  |  |  |  |  |  | Table
 |  |  |  |  |  |  |  |  |  |  |  |  | RMB/NTD

Sheet: LED間隔0.5cm
場地 | 長 | 寬 | 角鋼 | 立柱 | 天花板邊長 |  |  | esp32 掃描半徑 | WS2812最大數量 |  | 角鋼長度 | 角鋼數量 | 角鋼總長度
 | 1200 | 900 | 30 | 6 | 60 |  |  | 60 | 7200 |  | 1100 | 14 | 15400
有效長寬 | X | Y |  |  | X軸數量 | Y軸數量 | 天花板數量 | esp32 X軸數量 | esp32 Y軸數量 | esp32數量
 | 1100 | 800 |  |  | 18 | 13 | 234 | 9 | 7 | 63
 |  |  |  |  | 天花板面積 | 額外預備片數比例 | 額外預備片數 | 每片乘載LED | 每片需要pin | esp32總數量
 |  |  |  |  | 842400 | 0.05 | 12 | 53490 | 8 | 67
 |  |  |  |  |  |  | 天花板總數量
品名 | 單價 | 數量 | 額外費用 | 總價 |  |  | 246
WS2812B5050 | 0.05 | 3538080 |  | 176904
密迪板(4尺*8尺)*10片 | 300 | 4 |  | 1200
pcb板 | 30000 | 1 |  | 30000
電容 | 0.00352 | 3538080 |  | 12454.0416
電路加工費 | 1600 | 1 |  | 1600 | LED間隔 |  |  | PCB板大小 | 拼板大小
esp32、天線 | 180 | 67 |  | 12060 | 0.5 |  |  | 1 | 10
ESP32-S3-WROOM-1U N8R8 |  |  | 全部價格 | 234218.0416 | X軸數量 | Y軸數量 | LED數量 | 拼板上數量 | 總需要數量
 |  |  |  |  | 2160 | 1560 | 3369600 | 100 | 35390
 |  |  |  |  | LED總數量
 |  |  |  |  | 3538080
 |  |  |  |  | 單位X軸LED數量 | 單位Y軸LED數量 | 單位LED總數量
 |  |  |  |  | 120 | 120 | 14400

Sheet: LED間隔1cm
場地 | 長 | 寬 | 角鋼 | 立柱 | 天花板邊長 |  |  | esp32 掃描半徑 | WS2812最大數量 |  | 角鋼長度 | 角鋼數量 | 角鋼總長度
 | 1200 | 900 | 30 | 6 | 60 |  |  | 60 | 1800 |  | 1100 | 14 | 15400
有效長寬 | X | Y |  |  | X軸數量 | Y軸數量 | 天花板數量 | esp32 X軸數量 | esp32 Y軸數量 | esp32數量
 | 1100 | 800 |  |  | 18 | 13 | 234 | 9 | 7 | 63
 |  |  |  |  | 天花板面積 | 額外預備片數比例 | 額外預備片數 | 每片乘載LED | 每片需要pin | esp32總數量
 |  |  |  |  | 842400 | 0.05 | 12 | 13380 | 8 | 67
 |  |  |  |  |  |  | 天花板總數量
品名 | 單價 | 數量 | 額外費用 | 總價 |  |  | 246
WS2812B5050 | 0.08 | 884520 |  | 70762
密迪板(4尺*8尺)*10片 | 300 | 4 |  | 1200
pcb板 | 30000 | 1 |  | 30000
電容 | 0.00352 | 884520 |  | 3113.5104
電路加工費 | 1600 | 1 |  | 1600 | LED間隔 |  |  | PCB板大小 | 拼板大小
esp32、天線 | 180 | 67 |  | 12060 | 1 |  |  | 1 | 10
ESP32-S3-WROOM-1U N8R8 |  |  | 全部價格 | 118735.5104 | X軸數量 | Y軸數量 | LED數量 | 拼板上數量 | 總需要數量
 |  |  |  |  | 1080 | 780 | 842400 | 100 | 8850
 |  |  |  |  | LED總數量
 |  |  |  |  | 884520
 |  |  |  |  | 單位X軸LED數量 | 單位Y軸LED數量 | 單位LED總數量
 |  |  |  |  | 60 | 60 | 3600
