Andy-Cheng1017/LEDCeliling/CameraPosition/3d/GC9A01.STEP

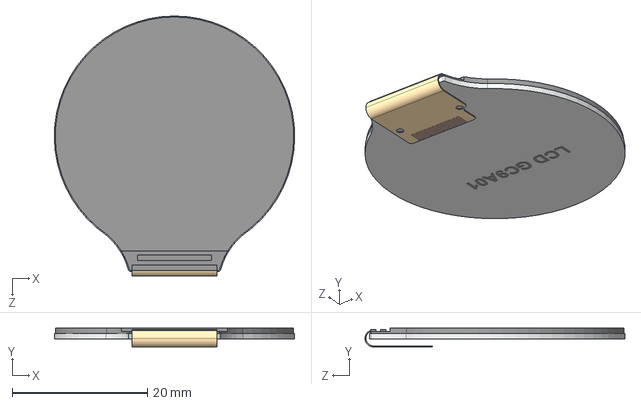
[picture p22: CAD file, 2023-03-01]
CameraPosition/3d/GC9A01.STEP
35.5 x 2.77 x 38.4 mm
