Andy-Cheng1017/LEDCeliling/Led_Control_Circuit/3d/3D_PCB1_2023-02-25.step

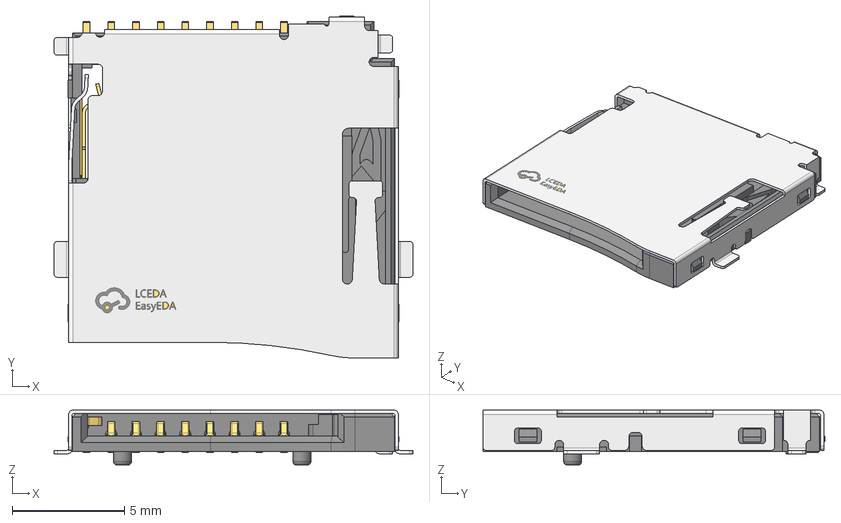
[picture p23: CAD file, 2023-02-28]
Led_Control_Circuit/3d/3D_PCB1_2023-02-25.step
16.0 x 15.2 x 2.45 mm
