Andy-Cheng1017/LEDCeliling/Power/3D/Jack Plug 5.step

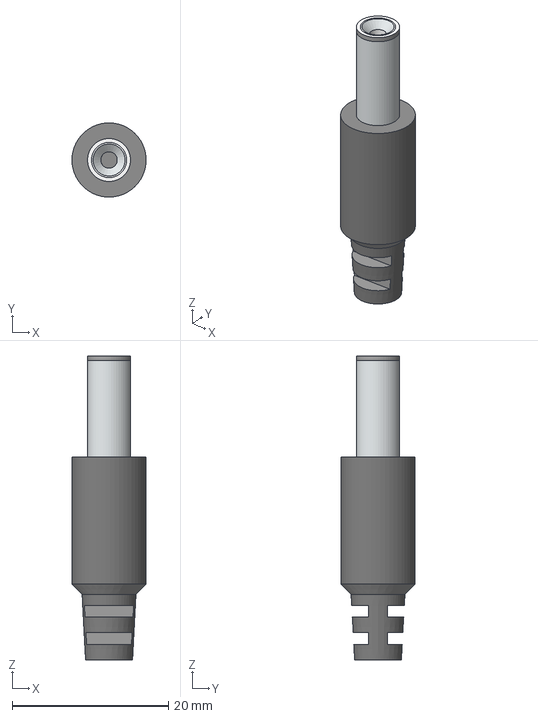
[picture p24: CAD file, 2023-02-23]
Power/3D/Jack Plug 5.step
9.49 x 9.50 x 38.9 mm
