Andy-Cheng1017/LEDCeliling/CameraPosition/3d/ov9655.stp

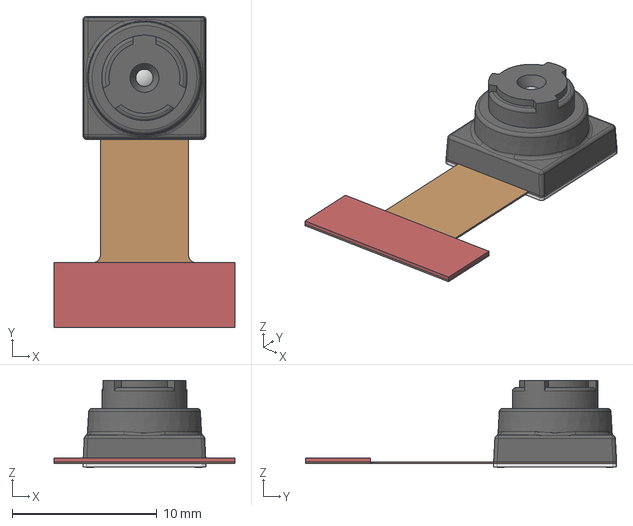
[picture p25: CAD file, 2023-02-28]
CameraPosition/3d/ov9655.stp
12.5 x 21.5 x 6.03 mm
