Andy-Cheng1017/LEDCeliling/Led_Control_Circuit/3d/Female Headers 2X10.step

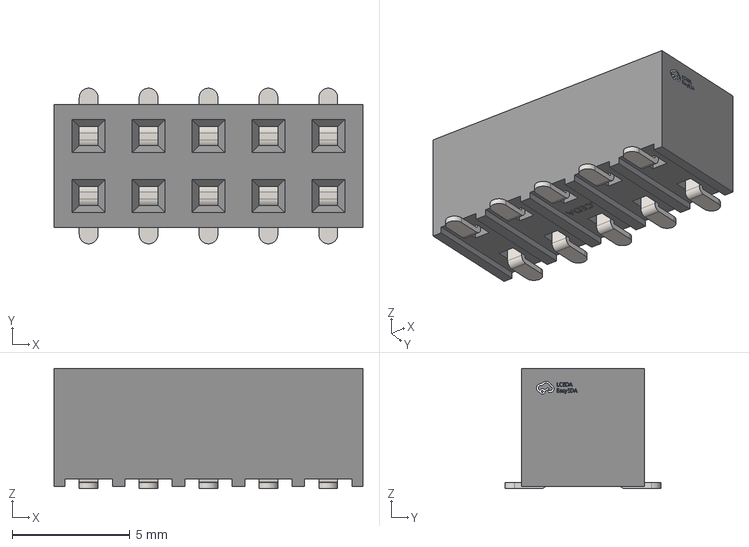
[picture p26: CAD file, 2023-02-28]
Led_Control_Circuit/3d/Female Headers 2X10.step
13.1 x 6.60 x 5.10 mm
