Andy-Cheng1017/LEDCeliling/Power/3D/Power Inductors SMD 11.6x10.1x4mm.step

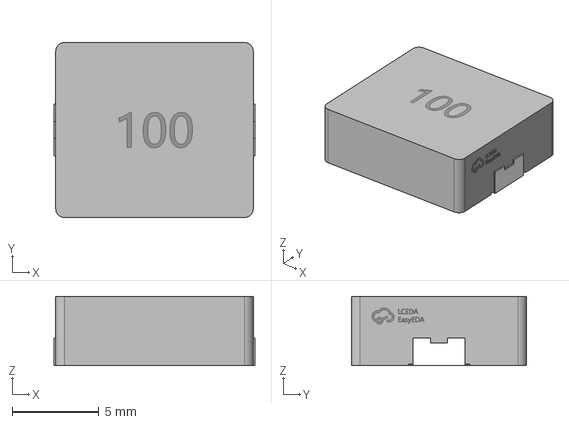
[picture p27: CAD file, 2023-02-23]
Power/3D/Power Inductors SMD 11.6x10.1x4mm.step
11.6 x 10.1 x 4.01 mm
