Andy-Cheng1017/LEDCeliling/CameraPosition/3d/FPC-24.stp

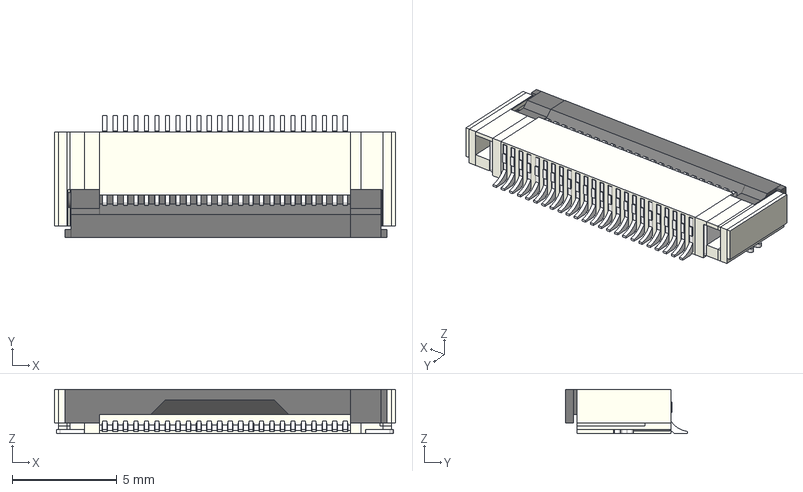
[picture p28: CAD file, 2023-02-28]
CameraPosition/3d/FPC-24.stp
16.3 x 5.85 x 2.11 mm
