Andy-Cheng1017/LEDCeliling/Power/3D/3_3MM SMD Variable Resistor.step

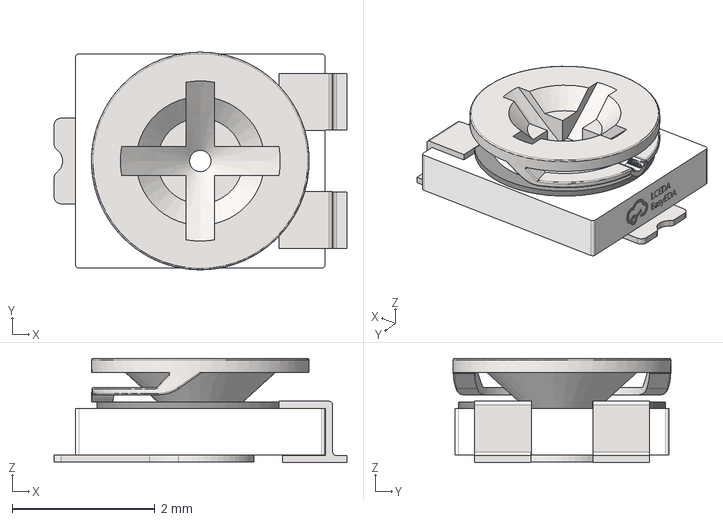
[picture p29: CAD file, 2023-02-23]
Power/3D/3_3MM SMD Variable Resistor.step
4.11 x 3.05 x 1.46 mm
