Andy-Cheng1017/LEDCeliling/CameraPosition/3d/HRO  TYPE-C-31-M-12.step

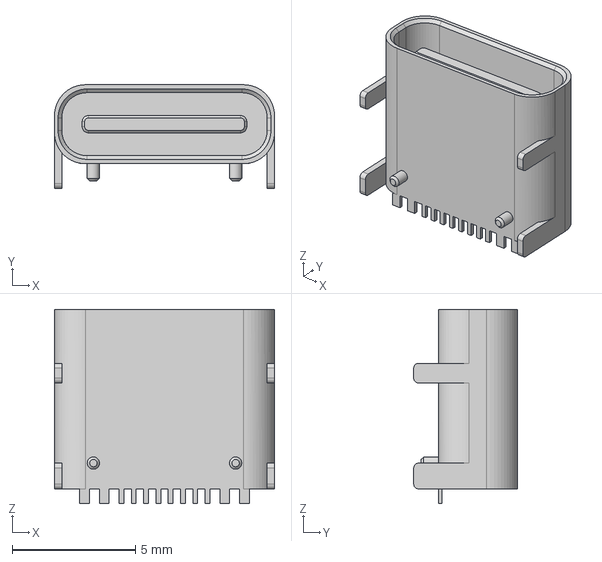
[picture p30: CAD file, 2023-02-28]
CameraPosition/3d/HRO TYPE-C-31-M-12.step
8.94 x 4.21 x 7.90 mm
