Andy-Cheng1017/LEDCeliling/Power/3D/DC 5.5mm 2.1mm.step

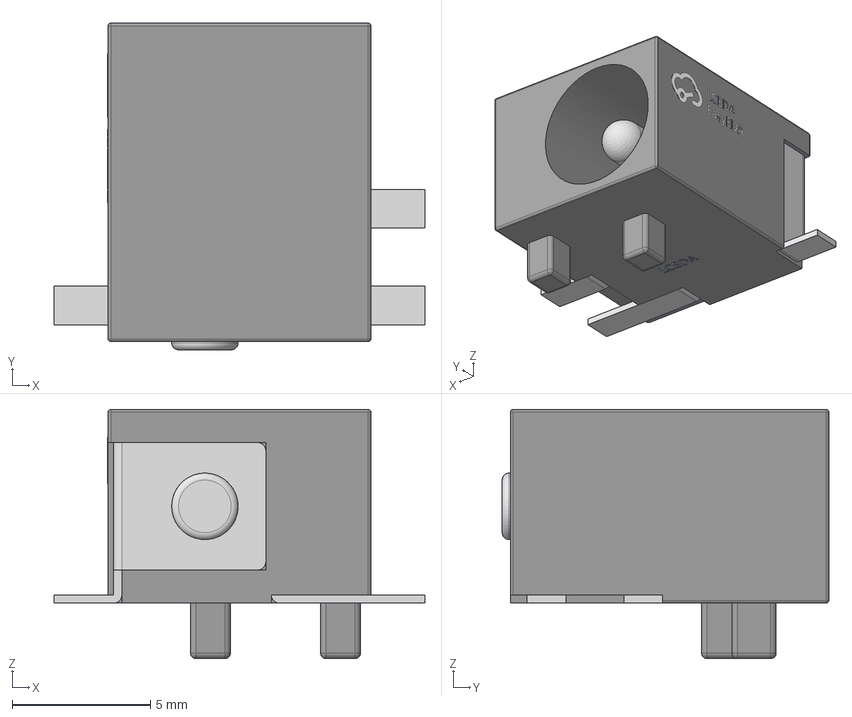
[picture p31: CAD file, 2023-02-23]
Power/3D/DC 5.5mm 2.1mm.step
13.4 x 11.8 x 9.00 mm
