Andy-Cheng1017/LEDCeliling/Power/3D/Power Inductors,7.5x6.6x5mm.step

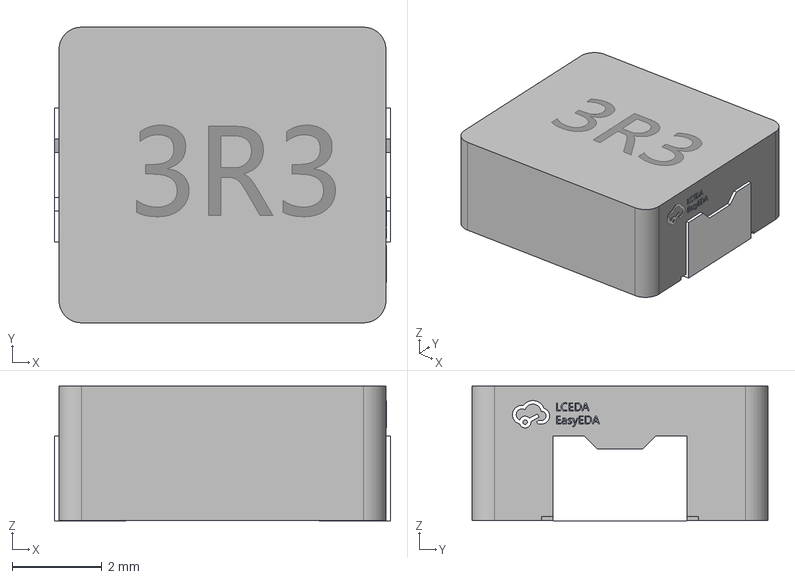
[picture p32: CAD file, 2023-02-23]
Power/3D/Power Inductors,7.5x6.6x5mm.step
7.50 x 6.60 x 3.01 mm
