Andy-Cheng1017/LEDCeliling/Power/3D/SOIC-10-1.step

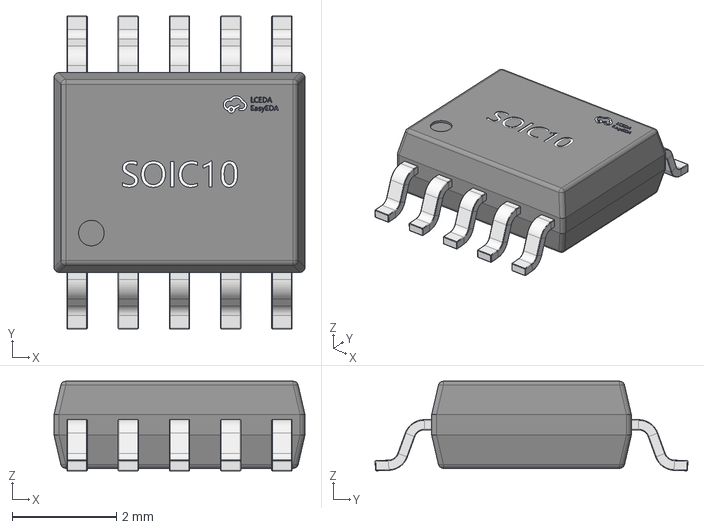
[picture p33: CAD file, 2023-02-23]
Power/3D/SOIC-10-1.step
4.81 x 6.00 x 1.72 mm
