Andy-Cheng1017/LEDCeliling/Power/Power.pdf

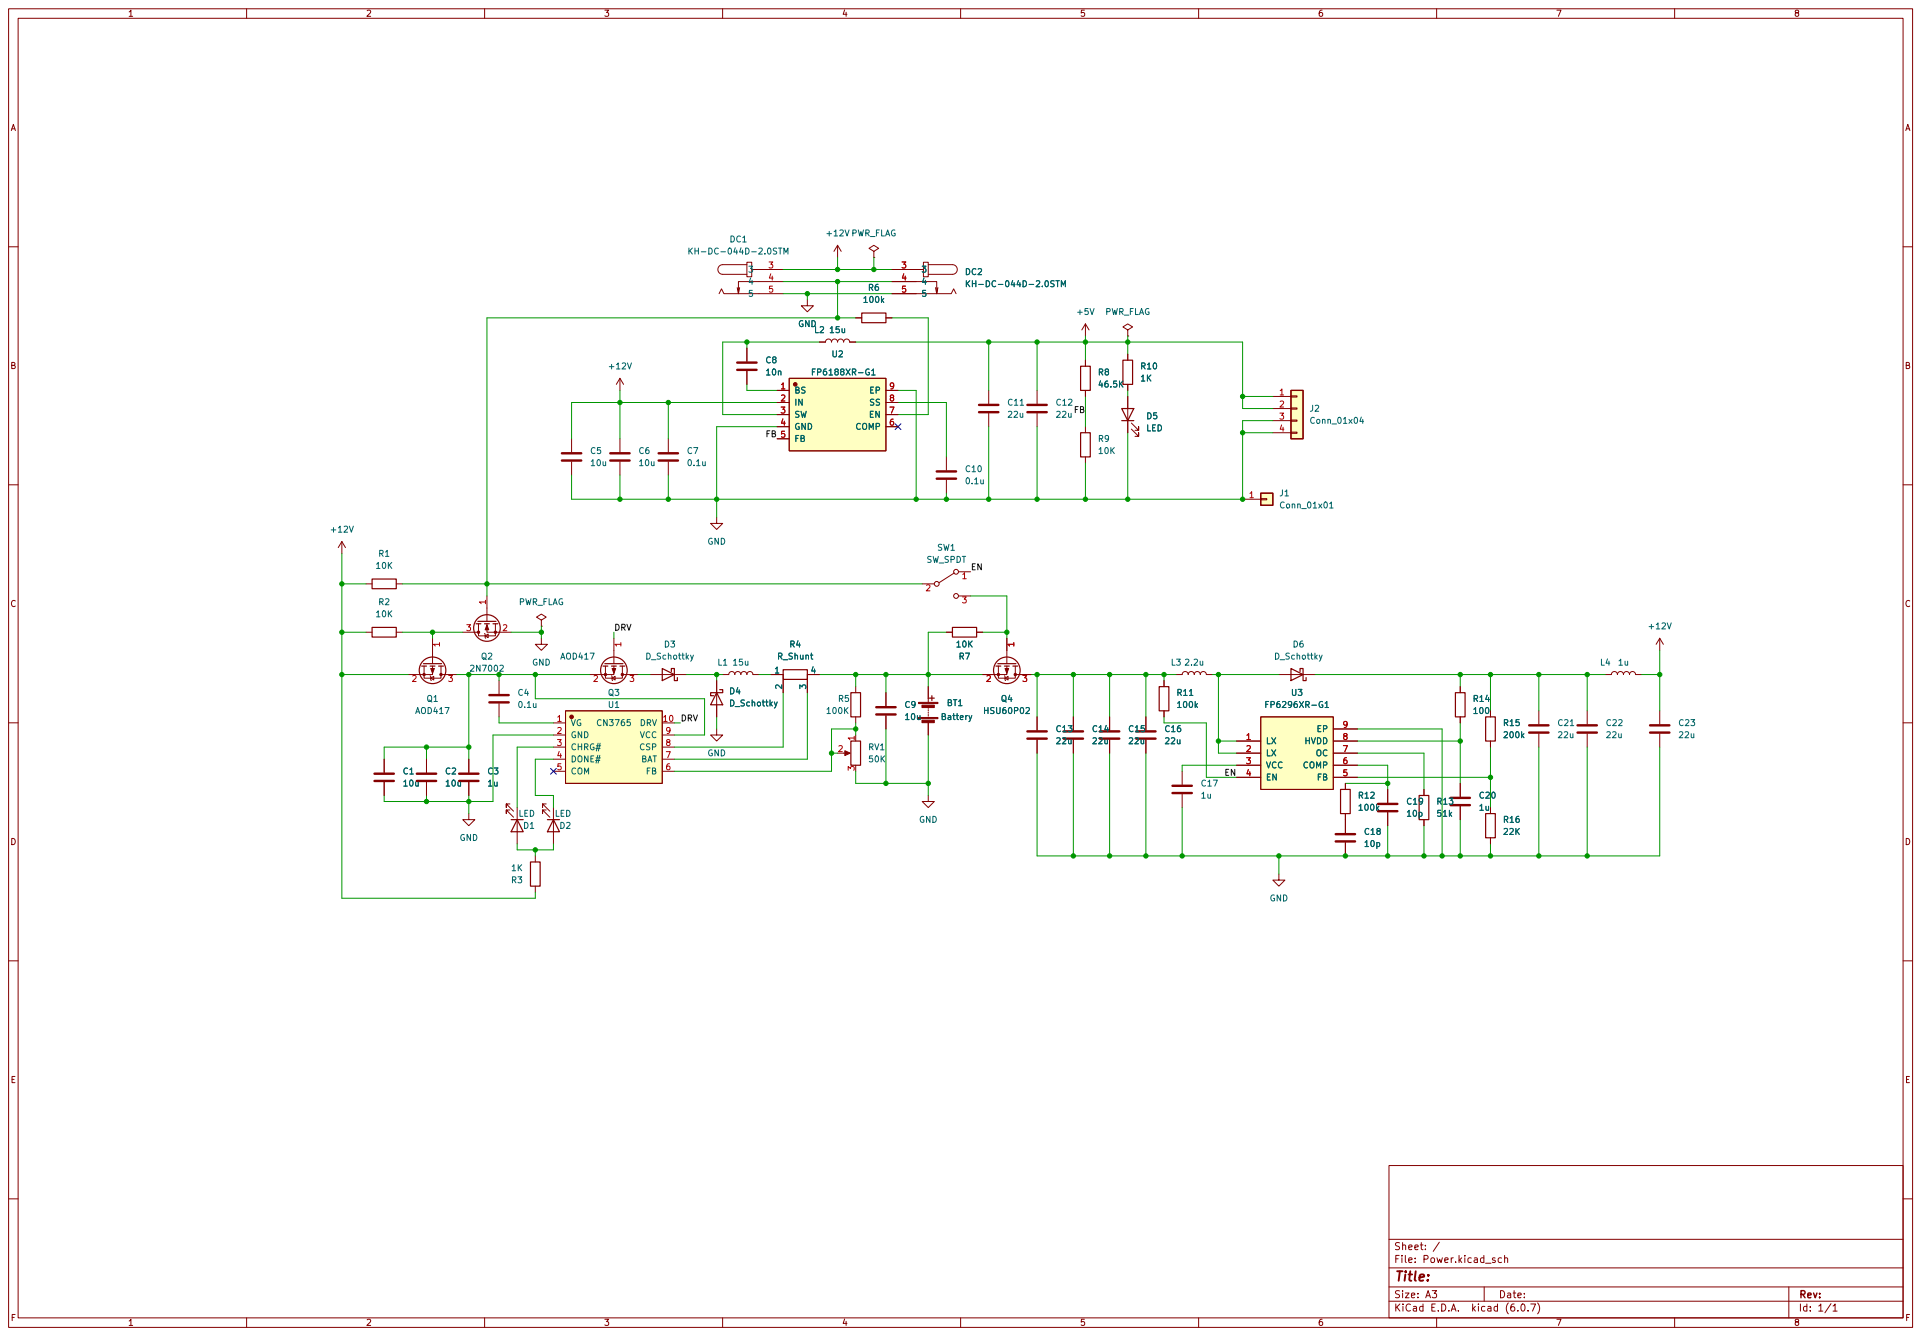
[picture p34: page 1]
