Andy-Cheng1017/LEDCeliling/(list of files, drawings)

Other design files:
esp32 S3文件/ESP32-S3-WROOM-1_V1.3_Reference_Design_0/01_Schematic/SCH_ESP32-S3-WROOM-1_V1.3_20220705.DSN
esp32 S3文件/ESP32-S3-WROOM-1_V1.3_Reference_Design_0/02_PCB/PCB_ESP32-S3-WROOM-1_V1.3_20220704.pcb
esp32 S3文件/ESP32-S3-WROOM-1U_V1.4_Reference_Design/ESP32-S3-WROOM-1U_V1.4_Reference_Design/01_Schematic/SCH_ESP32-S3-WROOM-1U_V1.4_20220705.DSN
esp32 S3文件/ESP32-S3-WROOM-1U_V1.4_Reference_Design/ESP32-S3-WROOM-1U_V1.4_Reference_Design/02_PCB/PCB_ESP32-S3-WROOM-1U_V1.4_20220704.pcb
