Andy-Cheng1017/LEDCeliling/Power/Power2.kicad_pcb

## KiCad design Power/Power2.kicad_pcb (2023-02-24)

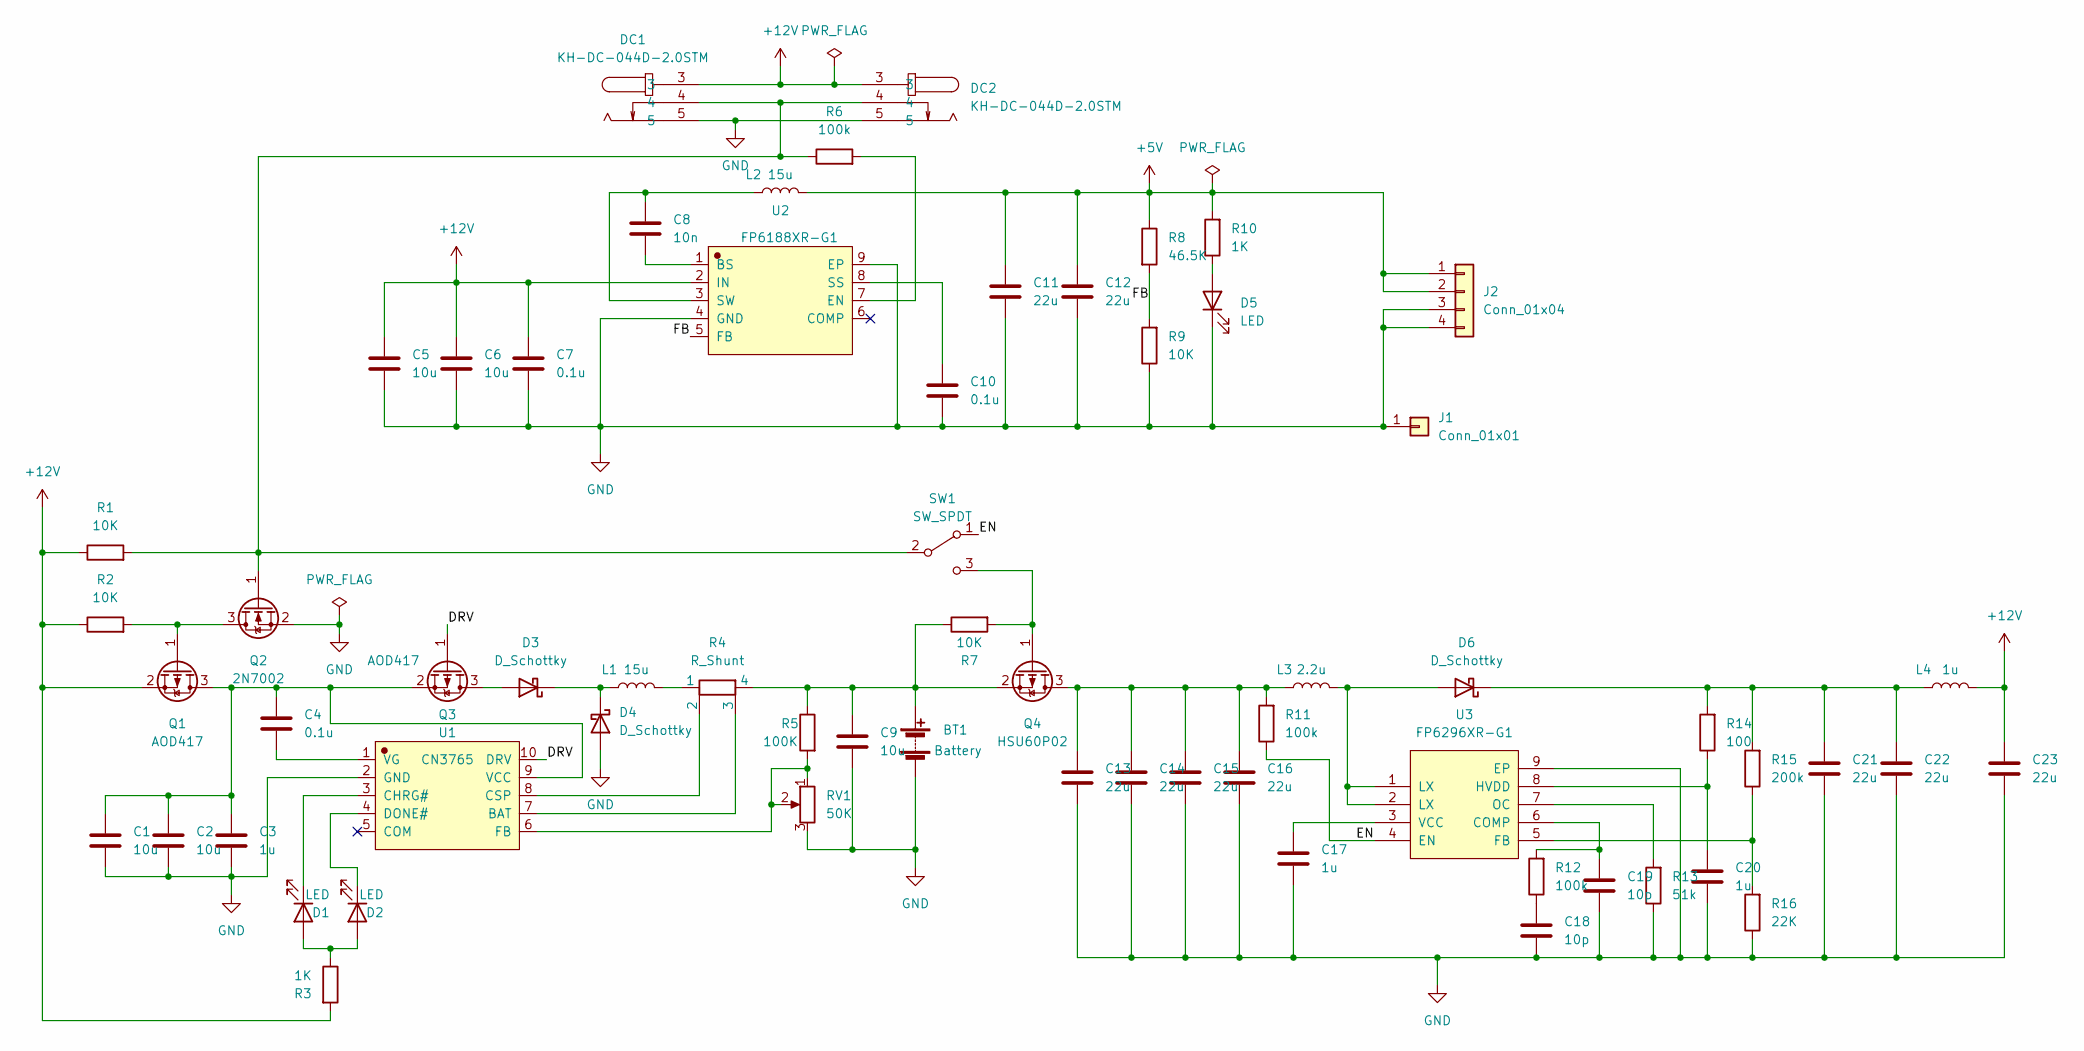
[picture p35: schematic Power2.kicad_sch]

Parts:
BT1: Battery
C1, C2, C5, C6, C9: 10u; C_0805_2012Metric
C3, C17, C20: 1u; C_0805_2012Metric
C4, C7, C10: 0.1u; C_0805_2012Metric
C8: 10n; C_0805_2012Metric
C11, C12, C13, C14, C15, C16, C21, C22, C23: 22u; C_0805_2012Metric
C18, C19: 10p; C_0805_2012Metric
D1, D2, D5: LED; LED_0805_2012Metric
D3, D4: D_Schottky; D_SMA
D6: D_Schottky; D_SMB
DC1, DC2: KH-DC-044D-2.0STM; DC-IN-TH_KH-DC-044D-2.0STM
J1: Conn_01x01; GndConnect
J2: Conn_01x04; VH3.96 4P SMT
L1, L2: 15u; IND-SMD_L7.5-W6.6
L3: 2.2u; IND-SMD_L7.5-W6.6
L4: 1u; L_1008_2520Metric
Q1, Q3: AOD417; TO-252-2
Q2: 2N7002; SOT-23
Q4: HSU60P02; TO-252-2
R1, R2, R7, R9: 10K; R_0805_2012Metric
R3, R10: 1K; R_0805_2012Metric
R4: R_Shunt; R_2512_6332Metric
R5: 100K; R_0805_2012Metric
R6, R11, R12: 100k; R_0805_2012Metric
R8: 46.5K; R_0805_2012Metric
R13: 51k; R_0805_2012Metric
R14: 100; R_0805_2012Metric
R15: 200k; R_0805_2012Metric
R16: 22K; R_0805_2012Metric
RV1: 50K; Potentiometer_Bourns_TC33X_Vertical
SW1: SW_SPDT; SW_SPDT_PCM12
U1: CN3765; SOIC-10_L4.9-W3.9-P1.00-LS6.0-BL
U2: FP6188XR-G1; SOIC-8-1EP_3.9x4.9mm_P1.27mm_EP2.95x4.9mm_Mask2.71x3.4mm_Th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
U3: FP6296XR-G1; SOIC-8-1EP_3.9x4.9mm_P1.27mm_EP2.95x4.9mm_Mask2.71x3.4mm_Th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

Connections:
+5V: C11.1, C12.1, J2.1, J2.2, L2.2, R8.1, R10.2
+12V: C5.1, C6.1, C7.1, C23.1, DC1.3, DC2.3, L4.2, Q1.2 (S), R1.1, R2.1, R3.2, U2.2 (IN)
/DRV: Q3.1 (G), U1.10 (DRV)
/EN: R11.1, SW1.1 (A), U3.4 (EN)
/FB: R8.2, R9.2, U2.5 (FB)
GND: BT1.2 (-), C1.2, C2.2, C3.2, C5.2, C6.2, C7.2, C9.2, C10.2, C11.2, C12.2, C13.2, C14.2, C15.2, C16.2, C17.2, C18.2, C19.2, C20.2, C21.2, C22.2, C23.2, D4.2 (A), D5.1 (K), DC1.5, DC2.5, J1.1, J2.3, J2.4, Q2.2 (S), R9.1, R13.1, R16.1, RV1.3, U1.2 (GND), U2.4 (GND), U2.9 (EP), U3.9 (EP)
unnamed: BT1.1 (+), C9.1, Q4.2 (S), R4.4, R5.1, R7.1
unnamed: C1.1, C2.1, C3.1, C4.1, Q1.3 (D), Q3.2 (S), U1.9 (VCC)
unnamed: C4.2, U1.1 (VG)
unnamed: C8.1, U2.1 (BS)
unnamed: C8.2, L2.1, U2.3 (SW)
unnamed: C10.1, U2.8 (SS)
unnamed: C13.1, C14.1, C15.1, C16.1, L3.1, Q4.3 (D), R11.2
unnamed: C17.1, U3.3 (VCC)
unnamed: C18.1, R12.1
unnamed: C19.1, R12.2, U3.6 (COMP)
unnamed: C20.1, R14.1, U3.8 (HVDD)
unnamed: C21.1, C22.1, D6.1 (K), L4.1, R14.2, R15.2
unnamed: D1.1 (K), U1.3 (CHRG#)
unnamed: D1.2 (A), D2.2 (A), R3.1
unnamed: D2.1 (K), U1.4 (DONE#)
unnamed: D3.1 (K), D4.1 (K), L1.1
unnamed: D3.2 (A), Q3.3 (D)
unnamed: D5.2 (A), R10.1
unnamed: D6.2 (A), L3.2, U3.1 (LX), U3.2 (LX)
unnamed: DC1.4, DC2.4, Q2.1 (G), R1.2, R6.1, SW1.2 (B)
unnamed: L1.2, R4.1
unnamed: Q1.1 (G), Q2.3 (D), R2.2
unnamed: Q4.1 (G), R7.2, SW1.3 (C)
unnamed: R4.2, U1.8 (CSP)
unnamed: R4.3, U1.7 (BAT)
unnamed: R5.2, RV1.1, RV1.2, U1.6 (FB)
unnamed: R6.2, U2.7 (EN)
unnamed: R13.2, U3.7 (OC)
unnamed: R15.1, R16.2, U3.5 (FB)

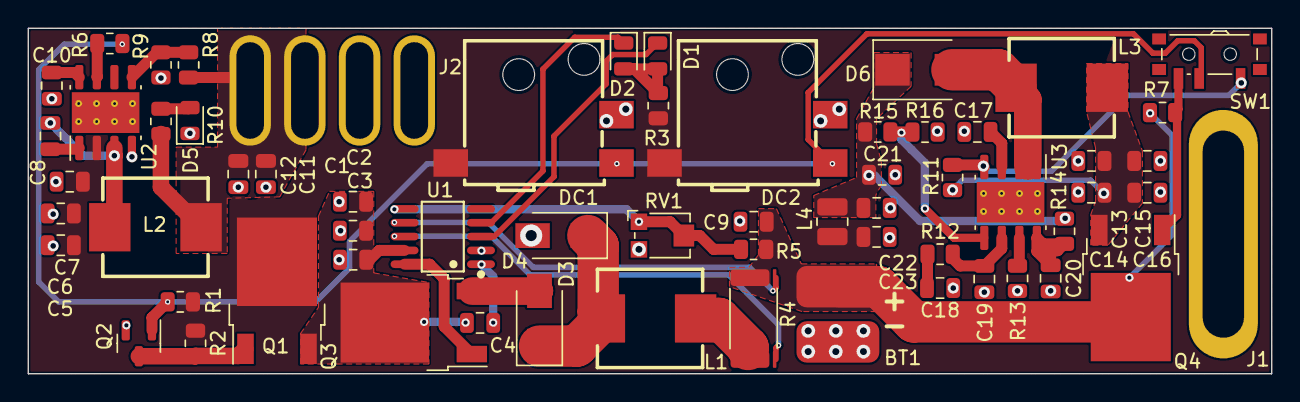
[picture p36: board Power2.kicad_pcb from above]

Board: 2 copper layers, 90.0 x 25.0 mm, 63 parts (0 on the bottom side), 35 nets.
