Andy-Cheng1017/LEDCeliling/CameraPosition/CameraPosition.kicad_pcb

## KiCad design CameraPosition/CameraPosition.kicad_pcb (2023-03-05)

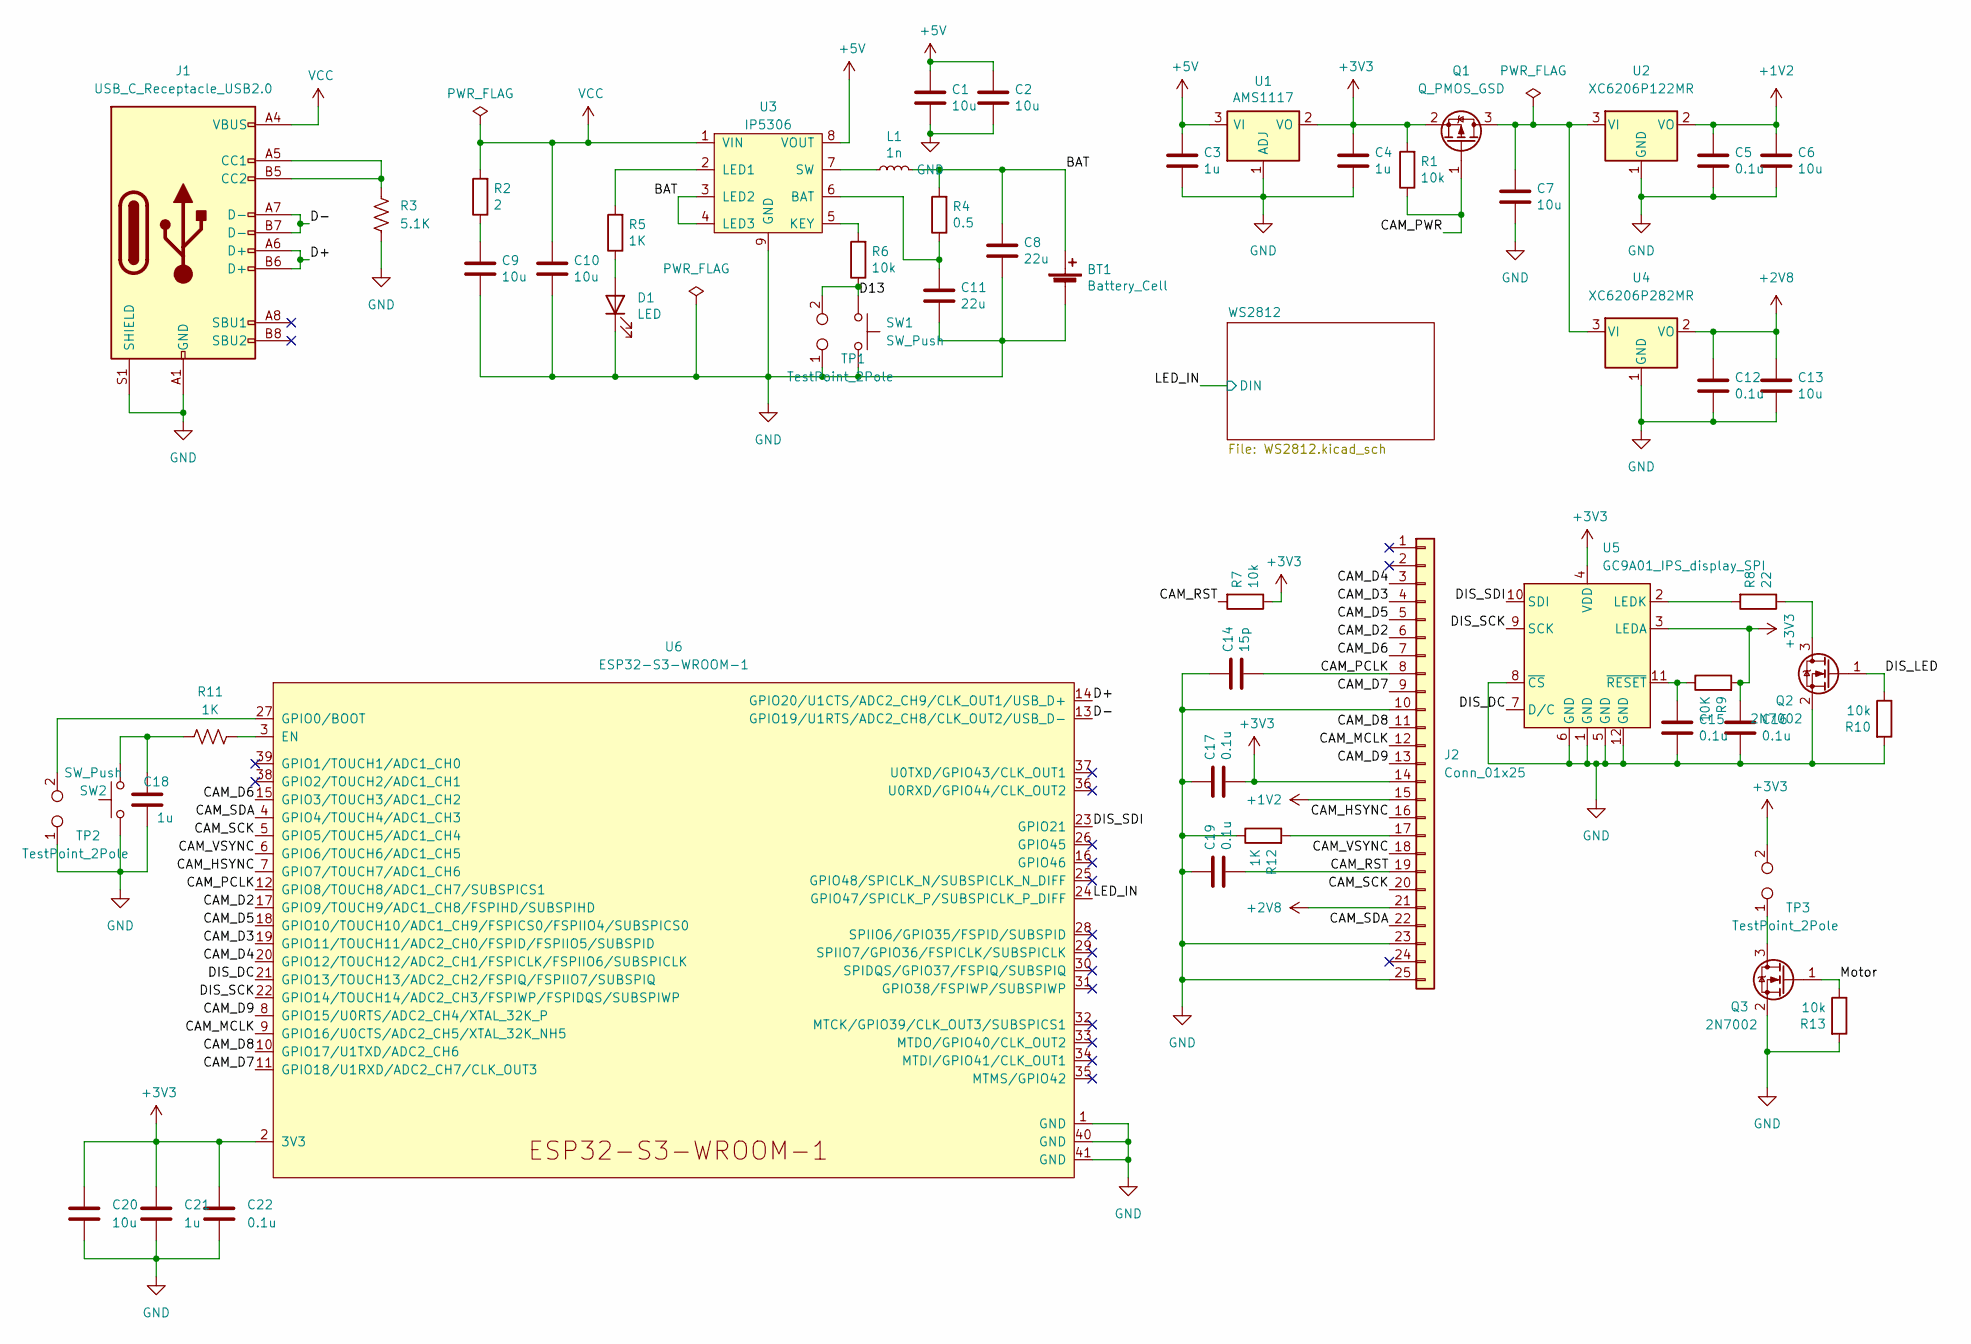
[picture p37: schematic CameraPosition.kicad_sch]

Parts:
BT1: Battery_Cell; PinHeader_1x02_P2.54mm_Vertical
C1, C2, C6, C7, C9, C10, C13, C20: 10u; C_0805_2012Metric
C3, C4, C18, C21: 1u; C_0805_2012Metric
C5, C12, C15, C16, C17, C19, C22: 0.1u; C_0805_2012Metric
C8, C11: 22u; C_0805_2012Metric
C14: 15p; C_0805_2012Metric
D1: LED; LED_0805_2012Metric
J1: USB_C_Receptacle_USB2.0; USB_C_Receptacle_HRO_TYPE-C-31-M-12
J2: Conn_01x25; Hirose_FH12-24S-0.5SH_1x24-1MP_P0.50mm_Horizontal
L1: 1n; L_Wuerth_MAPI-2512
Q1: Q_PMOS_GSD; SOT-23
Q2, Q3: 2N7002; SOT-23
R1, R6, R7, R10, R13: 10k; R_0805_2012Metric
R2: 2; R_0805_2012Metric
R3: 5.1K; R_0805_2012Metric
R4: 0.5; R_0805_2012Metric
R5, R11, R12: 1K; R_0805_2012Metric
R8: 22; R_0805_2012Metric
R9: 10K; R_0805_2012Metric
SW1, SW2: SW_Push; SW_SPST_CK_RS282G05A3
TP1, TP2, TP3: TestPoint_2Pole; PinHeader_1x02_P2.00mm_Vertical
U1: AMS1117; SOT-223-3_TabPin2
U2: XC6206P122MR; SOT-23
U3: IP5306; SOIC-8-1EP_3.9x4.9mm_P1.27mm_EP2.29x3mm
U4: XC6206P282MR; SOT-23
U5: GC9A01_IPS_display_SPI; GC9A01_IPS_display
U6: ESP32-S3-WROOM-1; ESP32-S3-WROOM-1U

Connections:
+1V2: C5.2, C6.2, J2.15, U2.2 (VO)
+2V8: C12.2, C13.2, J2.21, U4.2 (VO)
+3V3: C4.2, C16.2, C17.1, C20.1, C21.1, C22.1, J2.14, Q1.2 (S), R1.2, R7.1, R9.2, TP3.2, U1.2 (VO), U5.3 (LEDA), U5.4 (VDD), U6.2 (3V3)
+5V: C1.2, C2.2, C3.2, U1.3 (VI), U3.8 (VOUT); also elsewhere on the board
/BAT: BT1.1 (+), C8.2, L1.2, R4.2, U3.3 (LED2), U3.4 (LED3)
/CAM_D2: J2.6, U6.17 (GPIO9/TOUCH9/ADC1_CH8/FSPIHD/SUBSPIHD)
/CAM_D3: J2.4, U6.19 (GPIO11/TOUCH11/ADC2_CH0/FSPID/FSPIIO5/S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)
/CAM_D4: J2.3, U6.20 (GPIO12/TOUCH12/ADC2_CH1/FSPICLK/FSPIIO6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)
/CAM_D5: J2.5, U6.18 (GPIO10/TOUCH10/ADC1_CH9/FSPICS0/FSPIIO4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)
/CAM_D6: J2.7, U6.15 (GPIO3/TOUCH3/ADC1_CH2)
/CAM_D7: J2.9, U6.11 (GPIO18/U1RXD/ADC2_CH7/CLK_OUT3)
/CAM_D8: J2.11, U6.10 (GPIO17/U1TXD/ADC2_CH6)
/CAM_D9: J2.13, U6.8 (GPIO15/U0RTS/ADC2_CH4/XTAL_32K_P)
/CAM_HSYNC: J2.16, U6.7 (GPIO7/TOUCH7/ADC1_CH6)
/CAM_MCLK: J2.12, U6.9 (GPIO16/U0CTS/ADC2_CH5/XTAL_32K_NH5)
/CAM_PCLK: C14.1, J2.8, U6.12 (GPIO8/TOUCH8/ADC1_CH7/SUBSPICS1)
/CAM_PWR: Q1.1 (G), R1.1
/CAM_RST: C19.1, J2.19, R7.2
/CAM_SCK: J2.20, U6.5 (GPIO5/TOUCH5/ADC1_CH4)
/CAM_SDA: J2.22, U6.4 (GPIO4/TOUCH4/ADC1_CH3)
/CAM_VSYNC: J2.18, U6.6 (GPIO6/TOUCH6/ADC1_CH5)
/D13: R6.1, SW1.1, TP1.2
/D+: J1.A6 (D+), J1.B6 (D+), U6.14 (GPIO20/U1CTS/ADC2_CH9/CLK_OUT1/USB_D+)
/D-: J1.A7 (D-), J1.B7 (D-), U6.13 (GPIO19/U1RTS/ADC2_CH8/CLK_OUT2/USB_D-)
/DIS_DC: U5.7 (D/C), U6.21 (GPIO13/TOUCH13/ADC2_CH2/FSPIQ/FSPIIO7/S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)
/DIS_LED: Q2.1 (G), R10.1
/DIS_SCK: U5.9 (SCK), U6.22 (GPIO14/TOUCH14/ADC2_CH3/FSPIWP/FSPIDQS/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)
/DIS_SDI: U5.10 (SDI), U6.23 (GPIO21)
/LED_IN: U6.24 (GPIO47/SPICLK_P/SUBSPICLK_P_DIFF); also elsewhere on the board
/Motor: Q3.1 (G), R13.1
GND: BT1.2 (-), C1.1, C2.1, C3.1, C4.1, C5.1, C6.1, C7.1, C8.1, C9.1, C10.1, C11.1, C12.1, C13.1, C14.2, C15.1, C16.1, C17.2, C18.1, C19.2, C20.2, C21.2, C22.2, D1.1 (K), J1.A1 (GND), J1.A12 (GND), J1.B1 (GND), J1.B12 (GND), J1.S1 (SHIELD), J2.10, J2.23, J2.25, Q2.2 (S), Q3.2 (S), R3.2, R10.2, R12.1, R13.2, SW1.2, SW2.1, TP1.1, TP2.1, U1.1 (ADJ), U2.1 (GND), U3.9 (GND), U4.1 (GND), U5.1 (GND), U5.5 (GND), U5.6 (GND), U5.8 (~CS), U5.12 (GND), U6.1 (GND), U6.40 (GND), U6.41 (GND); also elsewhere on the board
unnamed: C7.2, Q1.3 (D), U2.3 (VI), U4.3 (VI)
unnamed: C9.2, R2.1
unnamed: C11.2, R4.1, U3.6 (BAT)
unnamed: C15.2, R9.1, U5.11 (~RESET)
unnamed: C18.2, R11.1, SW2.2
unnamed: D1.2 (A), R5.1
unnamed: J1.A5 (CC1), J1.B5 (CC2), R3.1
unnamed: J2.17, R12.2
unnamed: L1.1, U3.7 (SW)
unnamed: Q2.3 (D), R8.1
unnamed: Q3.3 (D), TP3.1
unnamed: R5.2, U3.2 (LED1)
unnamed: R6.2, U3.5 (KEY)
unnamed: R8.2, U5.2 (LEDK)
unnamed: R11.2, U6.3 (EN)
unnamed: TP2.2, U6.27 (GPIO0/BOOT)
VCC: C10.2, J1.A4 (VBUS), J1.A9 (VBUS), J1.B4 (VBUS), J1.B9 (VBUS), R2.2, U3.1 (VIN)

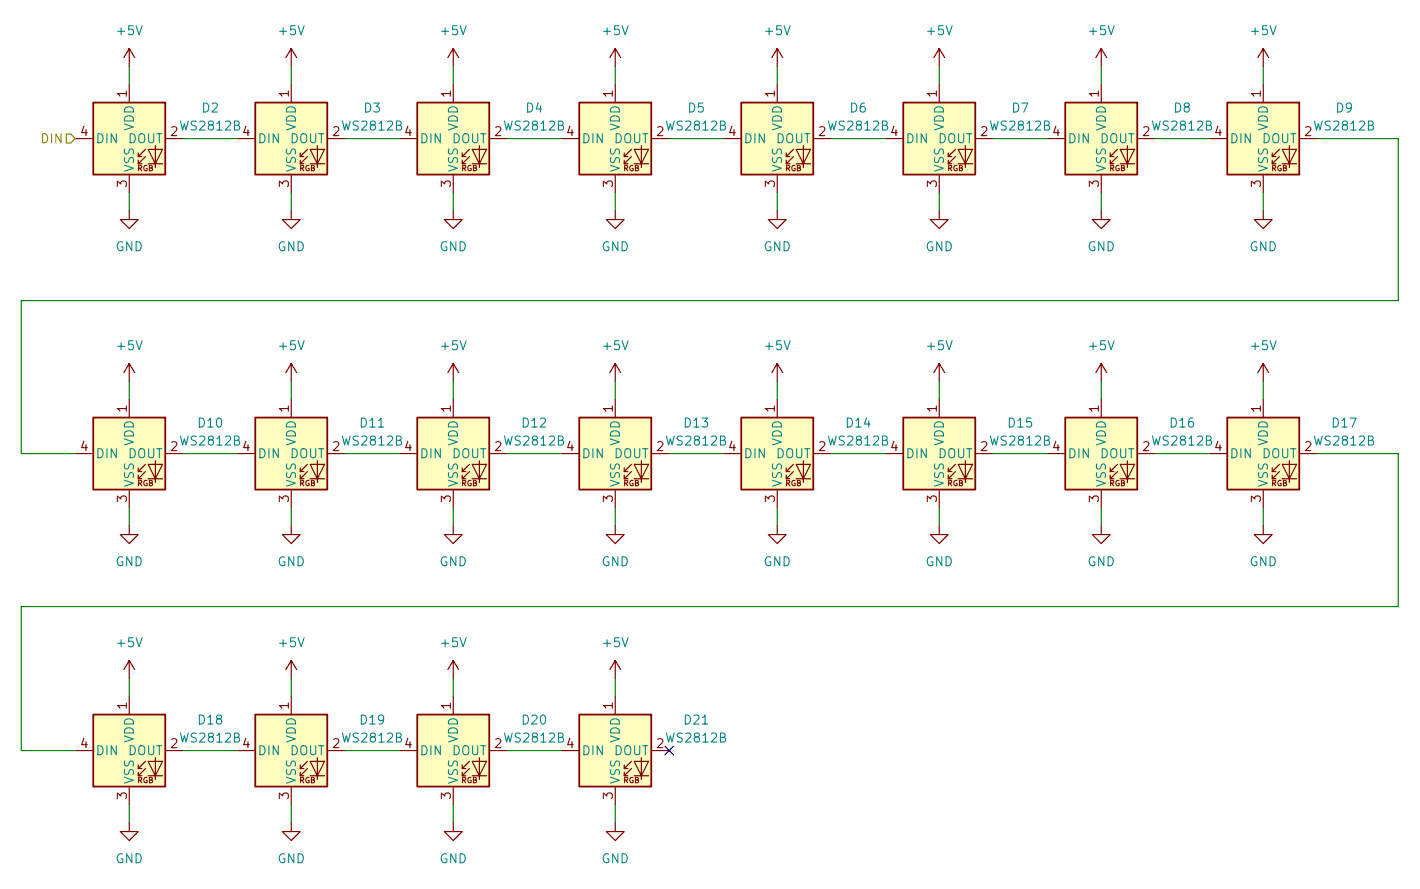
[picture p38: schematic WS2812.kicad_sch]

Parts:
D2, D3, D4, D5, D6, D7, D8, D9, D10, D11, D12, D13, D14, D15, D16, D17, D18, D19, D20, D21: WS2812B; LED_WS2812B_PLCC4_5.0x5.0mm_P3.2mm

Connections:
+5V: D2.1 (VDD), D3.1 (VDD), D4.1 (VDD), D5.1 (VDD), D6.1 (VDD), D7.1 (VDD), D8.1 (VDD), D9.1 (VDD), D10.1 (VDD), D11.1 (VDD), D12.1 (VDD), D13.1 (VDD), D14.1 (VDD), D15.1 (VDD), D16.1 (VDD), D17.1 (VDD), D18.1 (VDD), D19.1 (VDD), D20.1 (VDD), D21.1 (VDD); also elsewhere on the board
/LED_IN: D2.4 (DIN); also elsewhere on the board
GND: D2.3 (VSS), D3.3 (VSS), D4.3 (VSS), D5.3 (VSS), D6.3 (VSS), D7.3 (VSS), D8.3 (VSS), D9.3 (VSS), D10.3 (VSS), D11.3 (VSS), D12.3 (VSS), D13.3 (VSS), D14.3 (VSS), D15.3 (VSS), D16.3 (VSS), D17.3 (VSS), D18.3 (VSS), D19.3 (VSS), D20.3 (VSS), D21.3 (VSS); also elsewhere on the board
unnamed: D2.2 (DOUT), D3.4 (DIN)
unnamed: D3.2 (DOUT), D4.4 (DIN)
unnamed: D4.2 (DOUT), D5.4 (DIN)
unnamed: D5.2 (DOUT), D6.4 (DIN)
unnamed: D6.2 (DOUT), D7.4 (DIN)
unnamed: D7.2 (DOUT), D8.4 (DIN)
unnamed: D8.2 (DOUT), D9.4 (DIN)
unnamed: D10.2 (DOUT), D11.4 (DIN)
unnamed: D9.2 (DOUT), D10.4 (DIN)
unnamed: D11.2 (DOUT), D12.4 (DIN)
unnamed: D12.2 (DOUT), D13.4 (DIN)
unnamed: D13.2 (DOUT), D14.4 (DIN)
unnamed: D14.2 (DOUT), D15.4 (DIN)
unnamed: D15.2 (DOUT), D16.4 (DIN)
unnamed: D16.2 (DOUT), D17.4 (DIN)
unnamed: D17.2 (DOUT), D18.4 (DIN)
unnamed: D18.2 (DOUT), D19.4 (DIN)
unnamed: D19.2 (DOUT), D20.4 (DIN)
unnamed: D20.2 (DOUT), D21.4 (DIN)

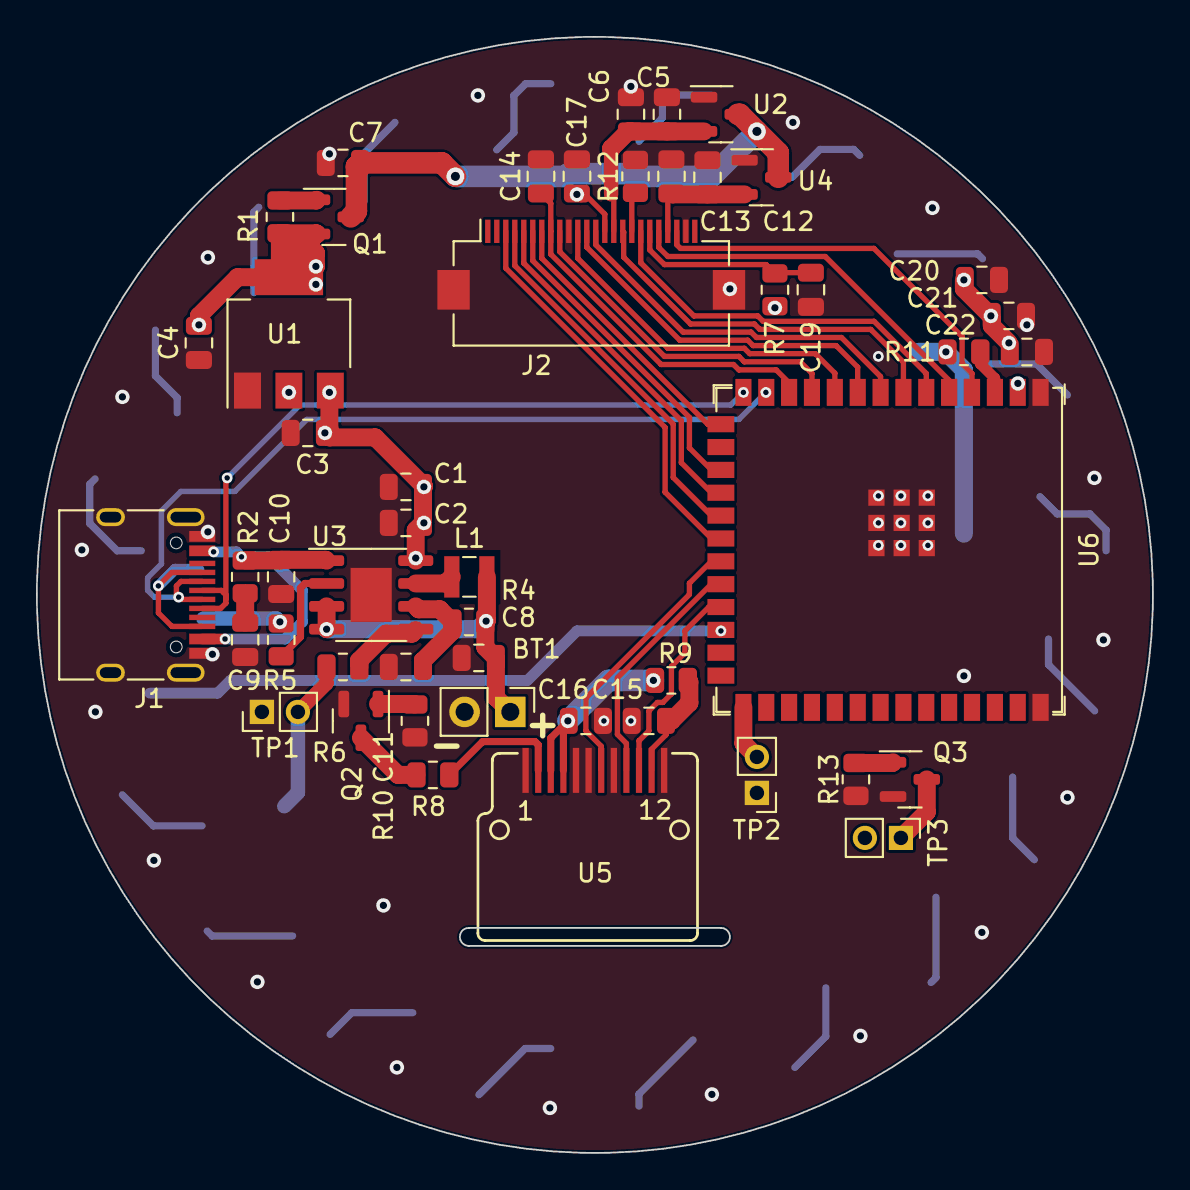
[picture p39: board CameraPosition.kicad_pcb from above]

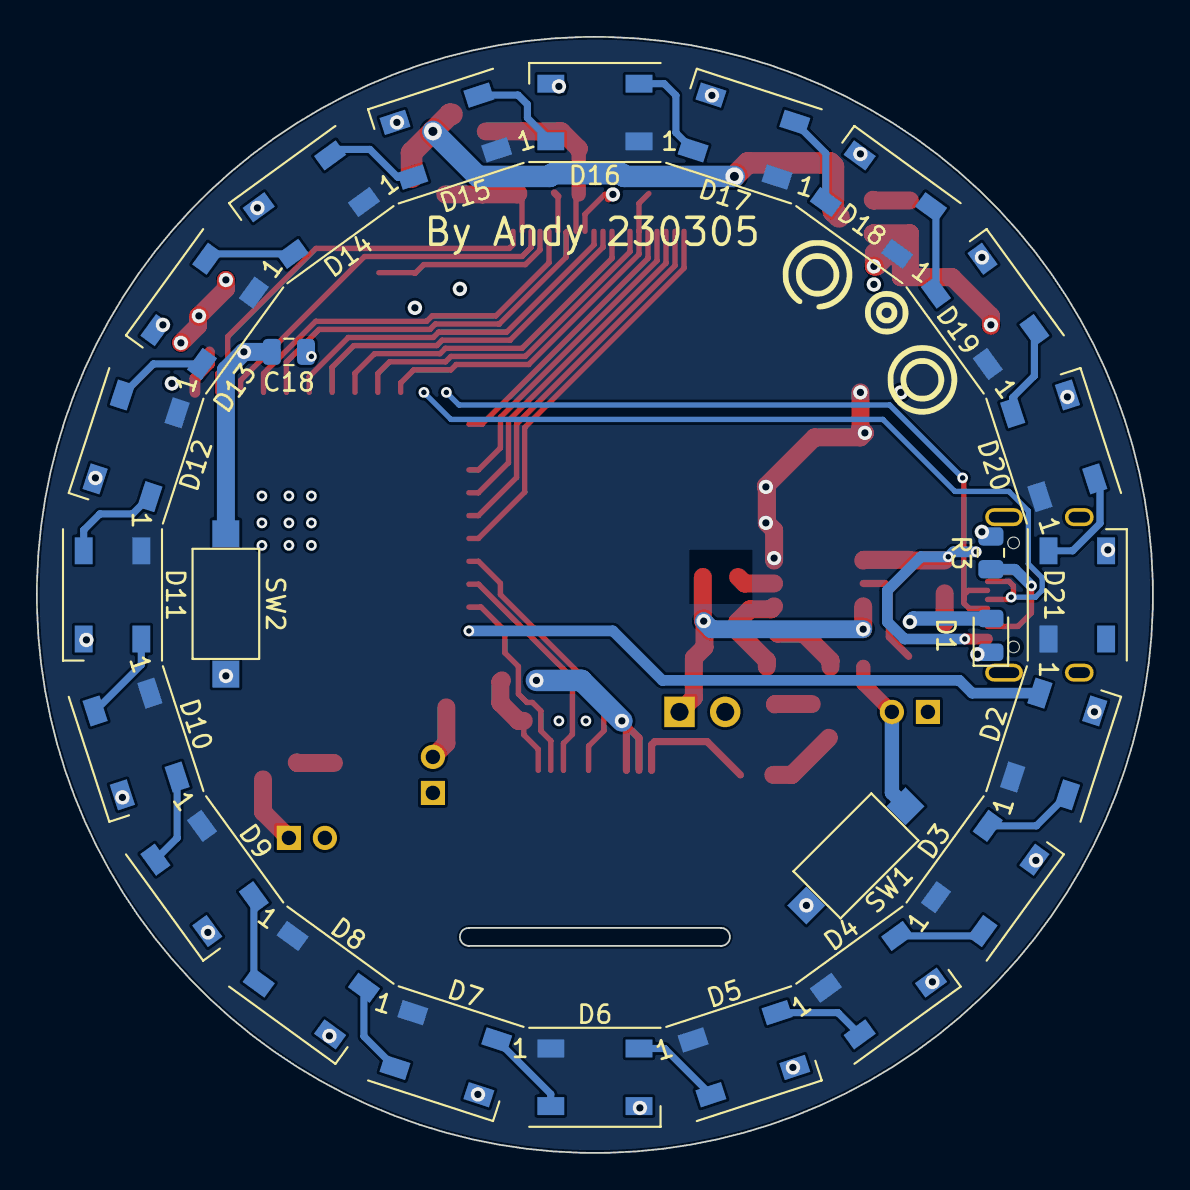
[picture p40: board CameraPosition.kicad_pcb from below]

Board: 4 copper layers, 62.0 x 62.0 mm, 74 parts (25 on the bottom side), 67 nets.
