Andy-Cheng1017/LEDCeliling/Led_Control_Circuit/Led_Control_Circuit.kicad_pcb

## KiCad design Led_Control_Circuit/Led_Control_Circuit.kicad_pcb (2023-02-28)

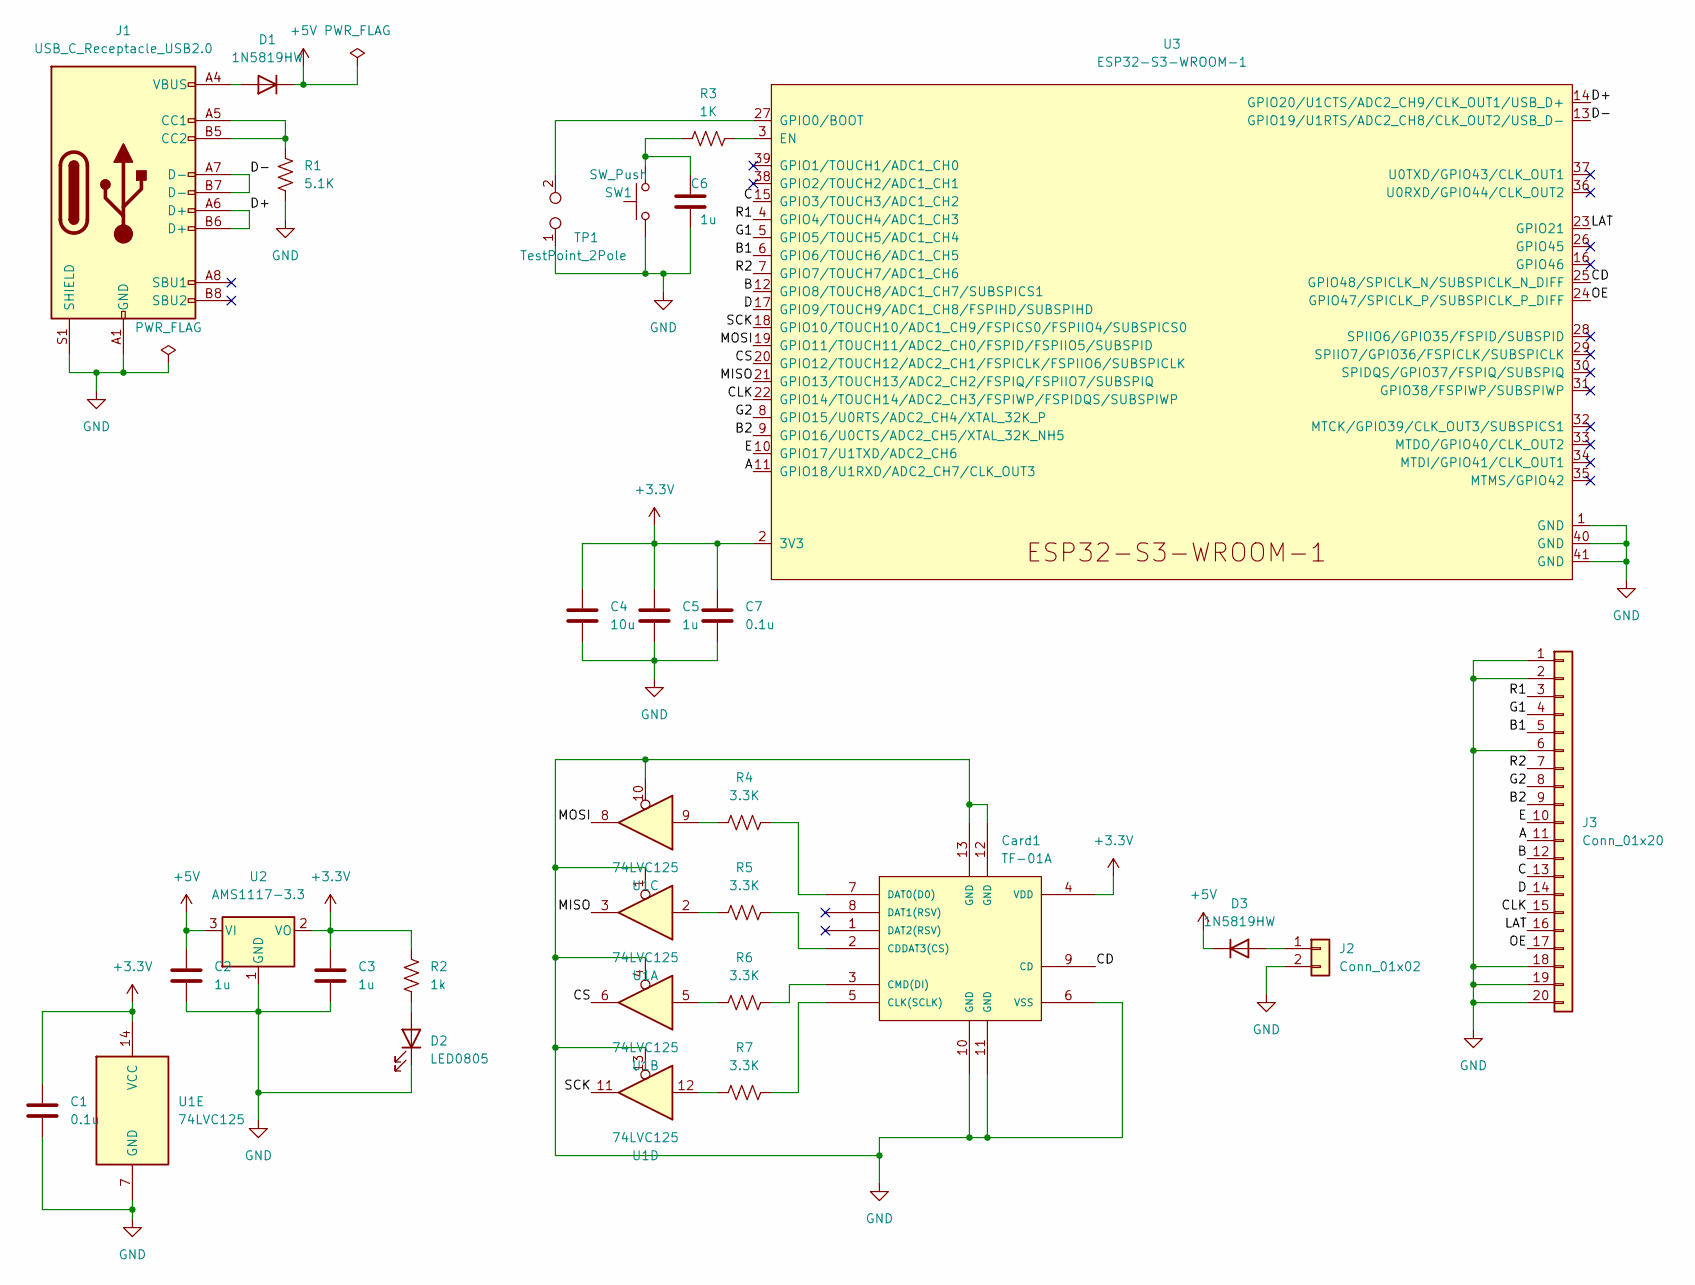
[picture p41: schematic Led_Control_Circuit.kicad_sch]

Parts:
C1, C7: 0.1u; C_0805_2012Metric
C2, C3, C5, C6: 1u; C_0805_2012Metric
C4: 10u; C_0805_2012Metric
Card1: TF-01A; TF-SMD_TF-01A
D1, D3: 1N5819HW; D_SOD-123
D2: LED0805; LED_0805_2012Metric
J1: USB_C_Receptacle_USB2.0; USB_C_Receptacle_HRO_TYPE-C-31-M-12
J2: Conn_01x02; Battery
J3: Conn_01x20; PinSocket_2x10_P2.54mm_Vertical_SMD
R1: 5.1K; R_0805_2012Metric
R2: 1k; R_0805_2012Metric
R3: 1K; R_0805_2012Metric
R4, R5, R6, R7: 3.3K; R_0805_2012Metric
SW1: SW_Push; SW_SPST_CK_RS282G05A3
TP1: TestPoint_2Pole; PinHeader_1x02_P2.00mm_Vertical
U1: 74LVC125; TSSOP-14_4.4x5mm_P0.65mm
U2: AMS1117-3.3; SOT-223-3_TabPin2
U3: ESP32-S3-WROOM-1; ESP32-S3-WROOM-1U

Connections:
+3.3V: C1.1, C3.1, C4.1, C5.1, C7.1, Card1.4 (VDD), R2.2, U1.14 (VCC), U2.2 (VO), U3.2 (3V3)
+5V: C2.1, D1.1 (K), D3.1 (K), U2.3 (VI)
/A: J3.11, U3.11 (GPIO18/U1RXD/ADC2_CH7/CLK_OUT3)
/B: J3.12, U3.12 (GPIO8/TOUCH8/ADC1_CH7/SUBSPICS1)
/B1: J3.5, U3.6 (GPIO6/TOUCH6/ADC1_CH5)
/B2: J3.9, U3.9 (GPIO16/U0CTS/ADC2_CH5/XTAL_32K_NH5)
/C: J3.13, U3.15 (GPIO3/TOUCH3/ADC1_CH2)
/CD: Card1.9 (CD), U3.25 (GPIO48/SPICLK_N/SUBSPICLK_N_DIFF)
/CLK: J3.15, U3.22 (GPIO14/TOUCH14/ADC2_CH3/FSPIWP/FSPIDQS/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)
/CS: U1.6, U3.20 (GPIO12/TOUCH12/ADC2_CH1/FSPICLK/FSPIIO6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)
/D: J3.14, U3.17 (GPIO9/TOUCH9/ADC1_CH8/FSPIHD/SUBSPIHD)
/D+: J1.A6 (D+), J1.B6 (D+), U3.14 (GPIO20/U1CTS/ADC2_CH9/CLK_OUT1/USB_D+)
/D-: J1.A7 (D-), J1.B7 (D-), U3.13 (GPIO19/U1RTS/ADC2_CH8/CLK_OUT2/USB_D-)
/E: J3.10, U3.10 (GPIO17/U1TXD/ADC2_CH6)
/G1: J3.4, U3.5 (GPIO5/TOUCH5/ADC1_CH4)
/G2: J3.8, U3.8 (GPIO15/U0RTS/ADC2_CH4/XTAL_32K_P)
/LAT: J3.16, U3.23 (GPIO21)
/MISO: U1.3, U3.21 (GPIO13/TOUCH13/ADC2_CH2/FSPIQ/FSPIIO7/S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)
/MOSI: U1.8, U3.19 (GPIO11/TOUCH11/ADC2_CH0/FSPID/FSPIIO5/S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)
/OE: J3.17, U3.24 (GPIO47/SPICLK_P/SUBSPICLK_P_DIFF)
/R1: J3.3, U3.4 (GPIO4/TOUCH4/ADC1_CH3)
/R2: J3.7, U3.7 (GPIO7/TOUCH7/ADC1_CH6)
/SCK: U1.11, U3.18 (GPIO10/TOUCH10/ADC1_CH9/FSPICS0/FSPIIO4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)
GND: C1.2, C2.2, C3.2, C4.2, C5.2, C6.1, C7.2, Card1.6 (VSS), Card1.10 (GND), Card1.11 (GND), Card1.12 (GND), Card1.13 (GND), D2.1 (K), J1.A1 (GND), J1.A12 (GND), J1.B1 (GND), J1.B12 (GND), J1.S1 (SHIELD), J2.2, J3.1, J3.2, J3.6, J3.18, J3.19, J3.20, R1.2, SW1.1, TP1.1, U1.1, U1.4, U1.7 (GND), U1.10, U1.13, U2.1 (GND), U3.1 (GND), U3.40 (GND), U3.41 (GND)
unnamed: C6.2, R3.1, SW1.2
unnamed: Card1.2 (CDDAT3(CS)), R5.1
unnamed: Card1.3 (CMD(DI)), R6.1
unnamed: Card1.5 (CLK(SCLK)), R7.1
unnamed: Card1.7 (DAT0(D0)), R4.1
unnamed: D1.2 (A), J1.A4 (VBUS), J1.A9 (VBUS), J1.B4 (VBUS), J1.B9 (VBUS)
unnamed: D2.2 (A), R2.1
unnamed: D3.2 (A), J2.1
unnamed: J1.A5 (CC1), J1.B5 (CC2), R1.1
unnamed: R3.2, U3.3 (EN)
unnamed: R4.2, U1.9
unnamed: R5.2, U1.2
unnamed: R6.2, U1.5
unnamed: R7.2, U1.12
unnamed: TP1.2, U3.27 (GPIO0/BOOT)

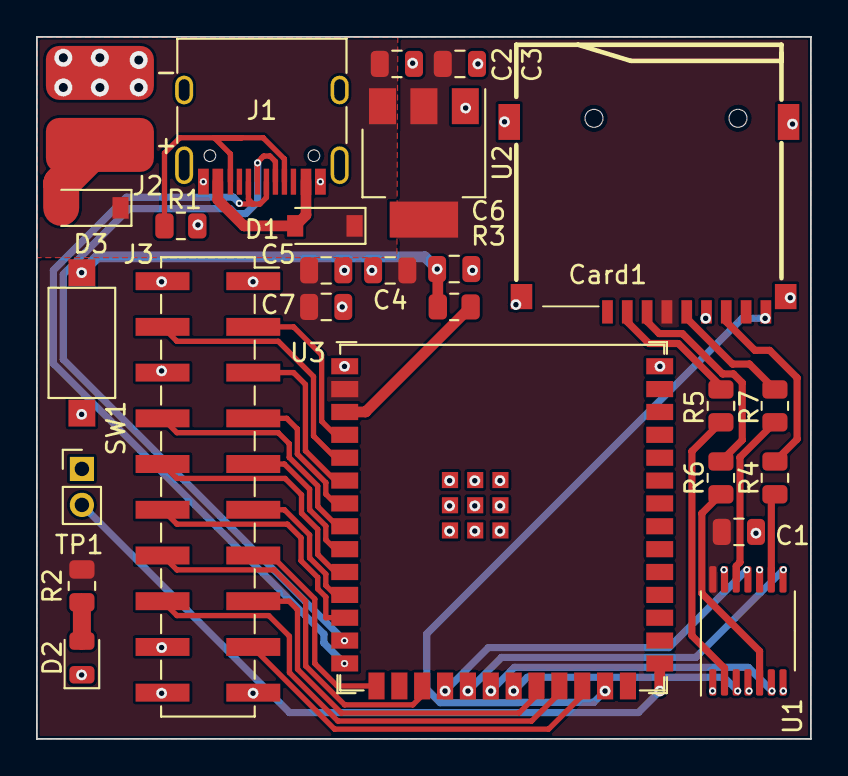
[picture p42: board Led_Control_Circuit.kicad_pcb from above]

Board: 2 copper layers, 43.0 x 39.0 mm, 26 parts (0 on the bottom side), 39 nets.
