Andy-Cheng1017/LEDCeliling/Led_Control_Circuit/Led_Control_Circuit_Panelization.kicad_pcb

## KiCad design Led_Control_Circuit/Led_Control_Circuit_Panelization.kicad_pcb (2023-02-28)

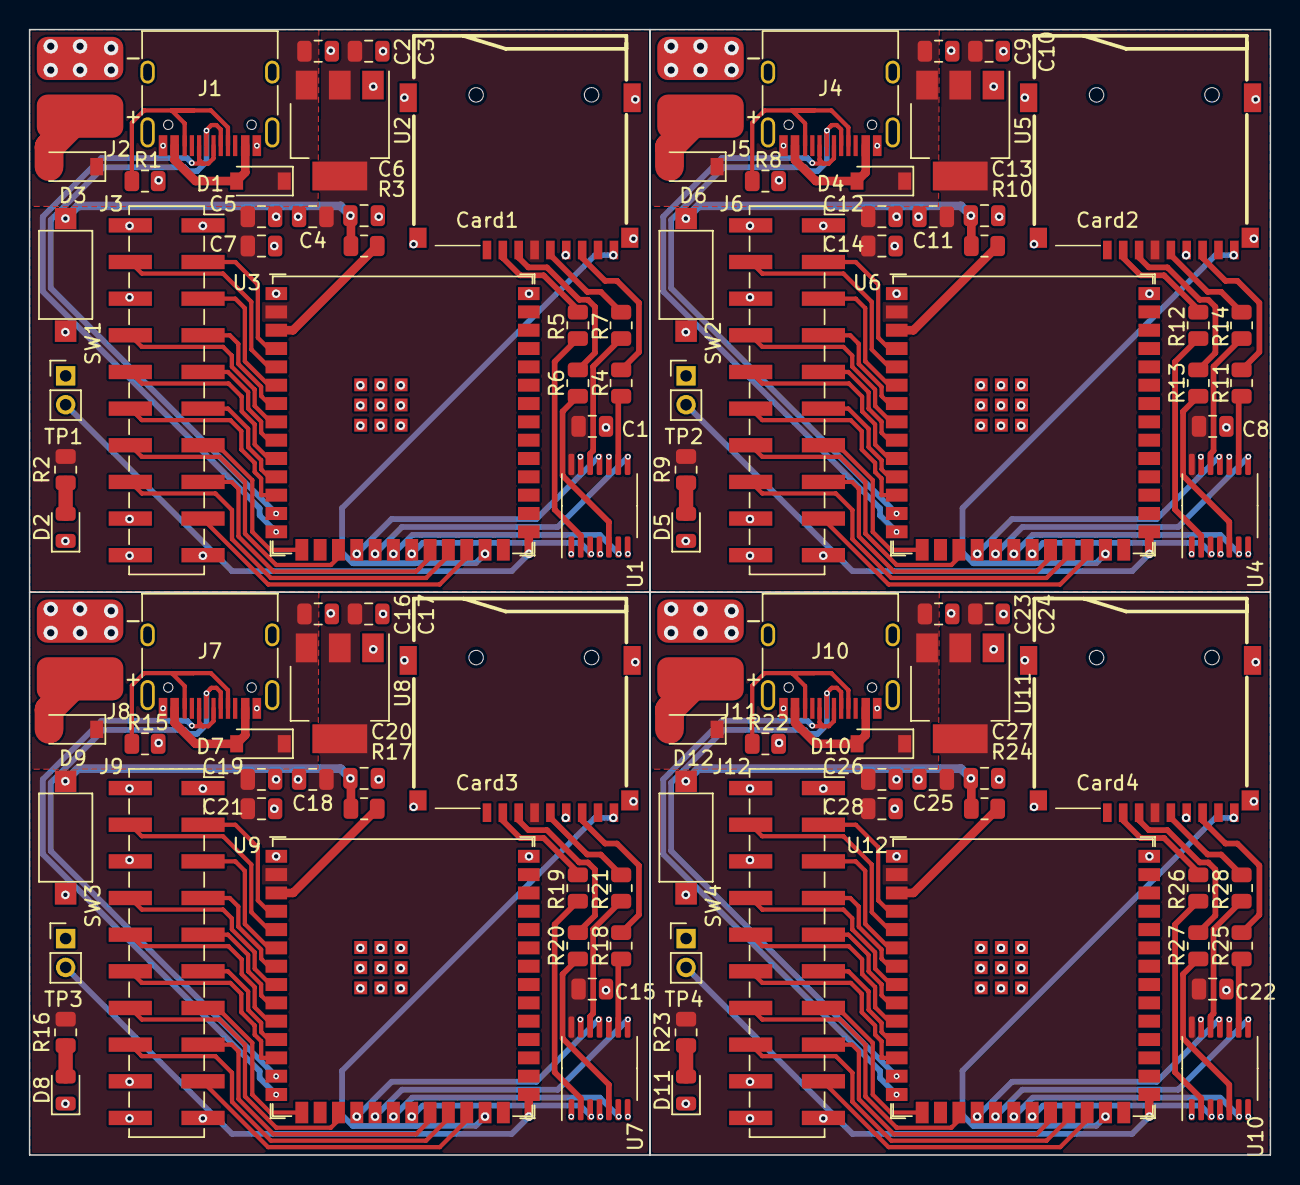
[picture p43: board Led_Control_Circuit_Panelization.kicad_pcb from above]

Board: 2 copper layers, 86.0 x 78.0 mm, 104 parts (0 on the bottom side), 39 nets.

Parts:
C1, C7, C8, C14, C15, C21, C22, C28: 0.1u; C_0805_2012Metric
C2, C3, C5, C6, C9, C10, C12, C13, C16, C17, C19, C20, C23, C24, C26, C27: 1u; C_0805_2012Metric
C4, C11, C18, C25: 10u; C_0805_2012Metric
Card1, Card2, Card3, Card4: TF-01A; TF-SMD_TF-01A
D1, D3, D4, D6, D7, D9, D10, D12: 1N5819HW; D_SOD-123
D2, D5, D8, D11: LED0805; LED_0805_2012Metric
J1, J4, J7, J10: USB_C_Receptacle_USB2.0; USB_C_Receptacle_HRO_TYPE-C-31-M-12
J2, J5, J8, J11: Conn_01x02; Battery
J3, J6, J9, J12: Conn_01x20; PinSocket_2x10_P2.54mm_Vertical_SMD
R1, R8, R15, R22: 5.1K; R_0805_2012Metric
R2, R9, R16, R23: 1k; R_0805_2012Metric
R3, R10, R17, R24: 1K; R_0805_2012Metric
R4, R5, R6, R7, R11, R12, R13, R14, R18, R19, R20, R21, R25, R26, R27, R28: 3.3K; R_0805_2012Metric
SW1, SW2, SW3, SW4: SW_Push; SW_SPST_CK_RS282G05A3
TP1, TP2, TP3, TP4: TestPoint_2Pole; PinHeader_1x02_P2.00mm_Vertical
U1, U4, U7, U10: 74LVC125; TSSOP-14_4.4x5mm_P0.65mm
U2, U5, U8, U11: AMS1117-3.3; SOT-223-3_TabPin2
U3, U6, U9, U12: ESP32-S3-WROOM-1; ESP32-S3-WROOM-1U

Connections:
+3.3V: C1.1, C3.1, C4.1, C5.1, C7.1, C8.1, C10.1, C11.1, C12.1, C14.1, C15.1, C17.1, C18.1, C19.1, C21.1, C22.1, C24.1, C25.1, C26.1, C28.1, Card1.4 (VDD), Card2.4 (VDD), Card3.4 (VDD), Card4.4 (VDD), R2.2, R9.2, R16.2, R23.2, U1.14 (VCC), U2.2 (VO), U3.2 (3V3), U4.14 (VCC), U5.2 (VO), U6.2 (3V3), U7.14 (VCC), U8.2 (VO), U9.2 (3V3), U10.14 (VCC), U11.2 (VO), U12.2 (3V3)
+5V: C2.1, C9.1, C16.1, C23.1, D1.1 (K), D3.1 (K), D4.1 (K), D6.1 (K), D7.1 (K), D9.1 (K), D10.1 (K), D12.1 (K), U2.3 (VI), U5.3 (VI), U8.3 (VI), U11.3 (VI)
/A: J3.11, J6.11, J9.11, J12.11, U3.11 (GPIO18/U1RXD/ADC2_CH7/CLK_OUT3), U6.11 (GPIO18/U1RXD/ADC2_CH7/CLK_OUT3), U9.11 (GPIO18/U1RXD/ADC2_CH7/CLK_OUT3), U12.11 (GPIO18/U1RXD/ADC2_CH7/CLK_OUT3)
/B: J3.12, J6.12, J9.12, J12.12, U3.12 (GPIO8/TOUCH8/ADC1_CH7/SUBSPICS1), U6.12 (GPIO8/TOUCH8/ADC1_CH7/SUBSPICS1), U9.12 (GPIO8/TOUCH8/ADC1_CH7/SUBSPICS1), U12.12 (GPIO8/TOUCH8/ADC1_CH7/SUBSPICS1)
/B1: J3.5, J6.5, J9.5, J12.5, U3.6 (GPIO6/TOUCH6/ADC1_CH5), U6.6 (GPIO6/TOUCH6/ADC1_CH5), U9.6 (GPIO6/TOUCH6/ADC1_CH5), U12.6 (GPIO6/TOUCH6/ADC1_CH5)
/B2: J3.9, J6.9, J9.9, J12.9, U3.9 (GPIO16/U0CTS/ADC2_CH5/XTAL_32K_NH5), U6.9 (GPIO16/U0CTS/ADC2_CH5/XTAL_32K_NH5), U9.9 (GPIO16/U0CTS/ADC2_CH5/XTAL_32K_NH5), U12.9 (GPIO16/U0CTS/ADC2_CH5/XTAL_32K_NH5)
/C: J3.13, J6.13, J9.13, J12.13, U3.15 (GPIO3/TOUCH3/ADC1_CH2), U6.15 (GPIO3/TOUCH3/ADC1_CH2), U9.15 (GPIO3/TOUCH3/ADC1_CH2), U12.15 (GPIO3/TOUCH3/ADC1_CH2)
/CD: Card1.9 (CD), Card2.9 (CD), Card3.9 (CD), Card4.9 (CD), U3.25 (GPIO48/SPICLK_N/SUBSPICLK_N_DIFF), U6.25 (GPIO48/SPICLK_N/SUBSPICLK_N_DIFF), U9.25 (GPIO48/SPICLK_N/SUBSPICLK_N_DIFF), U12.25 (GPIO48/SPICLK_N/SUBSPICLK_N_DIFF)
/CLK: J3.15, J6.15, J9.15, J12.15, U3.22 (GPIO14/TOUCH14/ADC2_CH3/FSPIWP/FSPIDQS/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), U6.22 (GPIO14/TOUCH14/ADC2_CH3/FSPIWP/FSPIDQS/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), U9.22 (GPIO14/TOUCH14/ADC2_CH3/FSPIWP/FSPIDQS/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), U12.22 (GPIO14/TOUCH14/ADC2_CH3/FSPIWP/FSPIDQS/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)
/CS: U1.6, U3.20 (GPIO12/TOUCH12/ADC2_CH1/FSPICLK/FSPIIO6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), U4.6, U6.20 (GPIO12/TOUCH12/ADC2_CH1/FSPICLK/FSPIIO6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), U7.6, U9.20 (GPIO12/TOUCH12/ADC2_CH1/FSPICLK/FSPIIO6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), U10.6, U12.20 (GPIO12/TOUCH12/ADC2_CH1/FSPICLK/FSPIIO6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)
/D: J3.14, J6.14, J9.14, J12.14, U3.17 (GPIO9/TOUCH9/ADC1_CH8/FSPIHD/SUBSPIHD), U6.17 (GPIO9/TOUCH9/ADC1_CH8/FSPIHD/SUBSPIHD), U9.17 (GPIO9/TOUCH9/ADC1_CH8/FSPIHD/SUBSPIHD), U12.17 (GPIO9/TOUCH9/ADC1_CH8/FSPIHD/SUBSPIHD)
/D+: J1.A6 (D+), J1.B6 (D+), J4.A6 (D+), J4.B6 (D+), J7.A6 (D+), J7.B6 (D+), J10.A6 (D+), J10.B6 (D+), U3.14 (GPIO20/U1CTS/ADC2_CH9/CLK_OUT1/USB_D+), U6.14 (GPIO20/U1CTS/ADC2_CH9/CLK_OUT1/USB_D+), U9.14 (GPIO20/U1CTS/ADC2_CH9/CLK_OUT1/USB_D+), U12.14 (GPIO20/U1CTS/ADC2_CH9/CLK_OUT1/USB_D+)
/D-: J1.A7 (D-), J1.B7 (D-), J4.A7 (D-), J4.B7 (D-), J7.A7 (D-), J7.B7 (D-), J10.A7 (D-), J10.B7 (D-), U3.13 (GPIO19/U1RTS/ADC2_CH8/CLK_OUT2/USB_D-), U6.13 (GPIO19/U1RTS/ADC2_CH8/CLK_OUT2/USB_D-), U9.13 (GPIO19/U1RTS/ADC2_CH8/CLK_OUT2/USB_D-), U12.13 (GPIO19/U1RTS/ADC2_CH8/CLK_OUT2/USB_D-)
/E: J3.10, J6.10, J9.10, J12.10, U3.10 (GPIO17/U1TXD/ADC2_CH6), U6.10 (GPIO17/U1TXD/ADC2_CH6), U9.10 (GPIO17/U1TXD/ADC2_CH6), U12.10 (GPIO17/U1TXD/ADC2_CH6)
/G1: J3.4, J6.4, J9.4, J12.4, U3.5 (GPIO5/TOUCH5/ADC1_CH4), U6.5 (GPIO5/TOUCH5/ADC1_CH4), U9.5 (GPIO5/TOUCH5/ADC1_CH4), U12.5 (GPIO5/TOUCH5/ADC1_CH4)
/G2: J3.8, J6.8, J9.8, J12.8, U3.8 (GPIO15/U0RTS/ADC2_CH4/XTAL_32K_P), U6.8 (GPIO15/U0RTS/ADC2_CH4/XTAL_32K_P), U9.8 (GPIO15/U0RTS/ADC2_CH4/XTAL_32K_P), U12.8 (GPIO15/U0RTS/ADC2_CH4/XTAL_32K_P)
/LAT: J3.16, J6.16, J9.16, J12.16, U3.23 (GPIO21), U6.23 (GPIO21), U9.23 (GPIO21), U12.23 (GPIO21)
/MISO: U1.3, U3.21 (GPIO13/TOUCH13/ADC2_CH2/FSPIQ/FSPIIO7/S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), U4.3, U6.21 (GPIO13/TOUCH13/ADC2_CH2/FSPIQ/FSPIIO7/S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), U7.3, U9.21 (GPIO13/TOUCH13/ADC2_CH2/FSPIQ/FSPIIO7/S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), U10.3, U12.21 (GPIO13/TOUCH13/ADC2_CH2/FSPIQ/FSPIIO7/S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)
/MOSI: U1.8, U3.19 (GPIO11/TOUCH11/ADC2_CH0/FSPID/FSPIIO5/S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), U4.8, U6.19 (GPIO11/TOUCH11/ADC2_CH0/FSPID/FSPIIO5/S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), U7.8, U9.19 (GPIO11/TOUCH11/ADC2_CH0/FSPID/FSPIIO5/S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), U10.8, U12.19 (GPIO11/TOUCH11/ADC2_CH0/FSPID/FSPIIO5/S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)
/OE: J3.17, J6.17, J9.17, J12.17, U3.24 (GPIO47/SPICLK_P/SUBSPICLK_P_DIFF), U6.24 (GPIO47/SPICLK_P/SUBSPICLK_P_DIFF), U9.24 (GPIO47/SPICLK_P/SUBSPICLK_P_DIFF), U12.24 (GPIO47/SPICLK_P/SUBSPICLK_P_DIFF)
/R1: J3.3, J6.3, J9.3, J12.3, U3.4 (GPIO4/TOUCH4/ADC1_CH3), U6.4 (GPIO4/TOUCH4/ADC1_CH3), U9.4 (GPIO4/TOUCH4/ADC1_CH3), U12.4 (GPIO4/TOUCH4/ADC1_CH3)
/R2: J3.7, J6.7, J9.7, J12.7, U3.7 (GPIO7/TOUCH7/ADC1_CH6), U6.7 (GPIO7/TOUCH7/ADC1_CH6), U9.7 (GPIO7/TOUCH7/ADC1_CH6), U12.7 (GPIO7/TOUCH7/ADC1_CH6)
/SCK: U1.11, U3.18 (GPIO10/TOUCH10/ADC1_CH9/FSPICS0/FSPIIO4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), U4.11, U6.18 (GPIO10/TOUCH10/ADC1_CH9/FSPICS0/FSPIIO4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), U7.11, U9.18 (GPIO10/TOUCH10/ADC1_CH9/FSPICS0/FSPIIO4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), U10.11, U12.18 (GPIO10/TOUCH10/ADC1_CH9/FSPICS0/FSPIIO4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)
GND: C1.2, C2.2, C3.2, C4.2, C5.2, C6.1, C7.2, C8.2, C9.2, C10.2, C11.2, C12.2, C13.1, C14.2, C15.2, C16.2, C17.2, C18.2, C19.2, C20.1, C21.2, C22.2, C23.2, C24.2, C25.2, C26.2, C27.1, C28.2, Card1.6 (VSS), Card1.10 (GND), Card1.11 (GND), Card1.12 (GND), Card1.13 (GND), Card2.6 (VSS), Card2.10 (GND), Card2.11 (GND), Card2.12 (GND), Card2.13 (GND), Card3.6 (VSS), Card3.10 (GND), Card3.11 (GND), Card3.12 (GND), Card3.13 (GND), Card4.6 (VSS), Card4.10 (GND), Card4.11 (GND), Card4.12 (GND), Card4.13 (GND), D2.1 (K), D5.1 (K), D8.1 (K), D11.1 (K), J1.A1 (GND), J1.A12 (GND), J1.B1 (GND), J1.B12 (GND), J1.S1 (SHIELD), J2.2, J3.1, J3.2, J3.6, J3.18, J3.19, J3.20, J4.A1 (GND), J4.A12 (GND), J4.B1 (GND), J4.B12 (GND), J4.S1 (SHIELD), J5.2, J6.1, J6.2, J6.6, J6.18, J6.19, J6.20, J7.A1 (GND), J7.A12 (GND), J7.B1 (GND), J7.B12 (GND), J7.S1 (SHIELD), J8.2, J9.1, J9.2, J9.6, J9.18, J9.19, J9.20, J10.A1 (GND), J10.A12 (GND), J10.B1 (GND), J10.B12 (GND), J10.S1 (SHIELD), J11.2, J12.1, J12.2, J12.6, J12.18, J12.19, J12.20, R1.2, R8.2, R15.2, R22.2, SW1.1, SW2.1, SW3.1, SW4.1, TP1.1, TP2.1, TP3.1, TP4.1, U1.1, U1.4, U1.7 (GND), U1.10, U1.13, U2.1 (GND), U3.1 (GND), U3.40 (GND), U3.41 (GND), U4.1, U4.4, U4.7 (GND), U4.10, U4.13, U5.1 (GND), U6.1 (GND), U6.40 (GND), U6.41 (GND), U7.1, U7.4, U7.7 (GND), U7.10, U7.13, U8.1 (GND), U9.1 (GND), U9.40 (GND), U9.41 (GND), U10.1, U10.4, U10.7 (GND), U10.10, U10.13, U11.1 (GND), U12.1 (GND), U12.40 (GND), U12.41 (GND)
unnamed: C6.2, C13.2, C20.2, C27.2, R3.1, R10.1, R17.1, R24.1, SW1.2, SW2.2, SW3.2, SW4.2
unnamed: Card1.2 (CDDAT3(CS)), Card2.2 (CDDAT3(CS)), Card3.2 (CDDAT3(CS)), Card4.2 (CDDAT3(CS)), R5.1, R12.1, R19.1, R26.1
unnamed: Card1.3 (CMD(DI)), Card2.3 (CMD(DI)), Card3.3 (CMD(DI)), Card4.3 (CMD(DI)), R6.1, R13.1, R20.1, R27.1
unnamed: Card1.5 (CLK(SCLK)), Card2.5 (CLK(SCLK)), Card3.5 (CLK(SCLK)), Card4.5 (CLK(SCLK)), R7.1, R14.1, R21.1, R28.1
unnamed: Card1.7 (DAT0(D0)), Card2.7 (DAT0(D0)), Card3.7 (DAT0(D0)), Card4.7 (DAT0(D0)), R4.1, R11.1, R18.1, R25.1
unnamed: D1.2 (A), D4.2 (A), D7.2 (A), D10.2 (A), J1.A4 (VBUS), J1.A9 (VBUS), J1.B4 (VBUS), J1.B9 (VBUS), J4.A4 (VBUS), J4.A9 (VBUS), J4.B4 (VBUS), J4.B9 (VBUS), J7.A4 (VBUS), J7.A9 (VBUS), J7.B4 (VBUS), J7.B9 (VBUS), J10.A4 (VBUS), J10.A9 (VBUS), J10.B4 (VBUS), J10.B9 (VBUS)
unnamed: D2.2 (A), D5.2 (A), D8.2 (A), D11.2 (A), R2.1, R9.1, R16.1, R23.1
unnamed: D3.2 (A), D6.2 (A), D9.2 (A), D12.2 (A), J2.1, J5.1, J8.1, J11.1
unnamed: J1.A5 (CC1), J1.B5 (CC2), J4.A5 (CC1), J4.B5 (CC2), J7.A5 (CC1), J7.B5 (CC2), J10.A5 (CC1), J10.B5 (CC2), R1.1, R8.1, R15.1, R22.1
unnamed: R3.2, R10.2, R17.2, R24.2, U3.3 (EN), U6.3 (EN), U9.3 (EN), U12.3 (EN)
unnamed: R4.2, R11.2, R18.2, R25.2, U1.9, U4.9, U7.9, U10.9
unnamed: R5.2, R12.2, R19.2, R26.2, U1.2, U4.2, U7.2, U10.2
unnamed: R6.2, R13.2, R20.2, R27.2, U1.5, U4.5, U7.5, U10.5
unnamed: R7.2, R14.2, R21.2, R28.2, U1.12, U4.12, U7.12, U10.12
unnamed: TP1.2, TP2.2, TP3.2, TP4.2, U3.27 (GPIO0/BOOT), U6.27 (GPIO0/BOOT), U9.27 (GPIO0/BOOT), U12.27 (GPIO0/BOOT)
