Andy-Cheng1017/LEDCeliling/(commit log)

2022-09-26 Excel文件完成，小電路完成
    [WS2812bCricuit.kicad_pcb, WS2812bCricuit.kicad_sch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]
2022-09-26 9/26更新
    [價格計算.xlsx]
2022-09-27 新增控制電路
    [Led_Control_Circuit.kicad_pcb, Led_Control_Circuit.kicad_sch]
2022-09-28 新增文件
    [BOM(V0.7)_ESP32-S3-WROOM-1U.xls, BOM(V0.8)_ESP32-S3-WROOM-1.xls, Led_Control_Circuit.kicad_sch, PCB_ESP32-S3-WROOM-1U_V1.4_20220704.pcb, PCB_ESP32-S3-WROOM-1_V1.3_20220704.pcb, SCH_ESP32-S3-WROOM-1U_V1.4_20220705.DSN, SCH_ESP32-S3-WROOM-1_V1.3_20220705.DSN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]
